ReMured/PEP/Analoger Signalgenerator.pptx

## Analoger Signalgenerator

Ein Projekt des Wahlfachs PEP von marius Heckl und Pascal palatz

## Gliederung

- Anforderungen
- Unsere Platine
- Herausforderungen und Lösungen
- Ausgangssignal Wien-Robinson-Generator
- Ausgangsignal Sinus
- Ausgangsignal Rechteck
- Ausgangsignal Dreieck
- Ausgangsignal PWM
- Ausgangsignal Sägezahn
- Weitere Videos (Amplitude und Offset)

## Anforderungen

Projekt Signalgenerator - Anforderungen -

- Entwicklung eines analogen Signalgenerators
- Folgende Signale sollen generiert werden:
  - Sinus
  - Rechteck
  - Dreieck
  - PWM
  - Sägezahn
- Frequenzen der Signale sollen zwischen 1 kHz und 1 MHz einstellbar sein
- Die Amplitude und der Offset soll bei allen Signalen einstellbar sein

## Unsere Platine

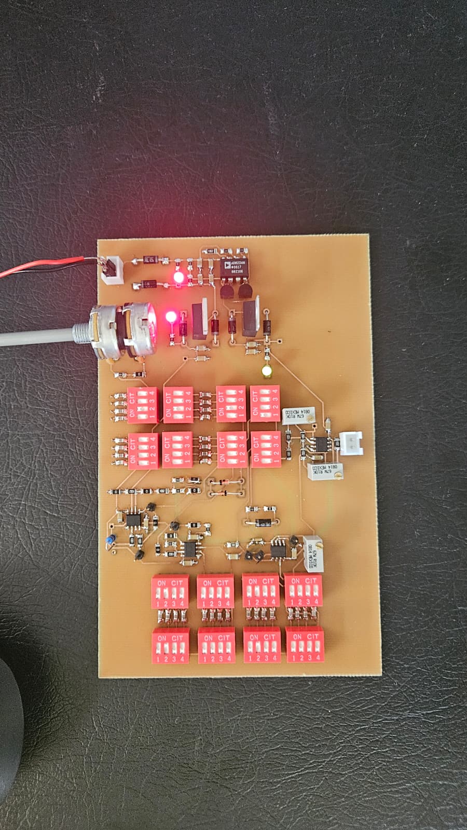
[picture p1: figure]

Projekt Signalgenerator - Unsere Platine -

- Kenndaten unserer Platine:
  - Spannungsversorgung:
    - Netzteilversorgung: ± 15 V
    - Interne Spannungsversorgung: ± 5 V
  - Signalgenerator:
    - Wien-Robinson-Generator: Erzeugt ein Sinus mit minimal 4,06 kHz und maximal 1,63 MHz
  - Signalverarbeitungen:
    - Signalerzeugung: Erzeugt aus dem Sinus des Generators :
      - Verstärkter Sinus
      - Rechteck
      - Dreieck
      - PWM
      - Sägezahn
  - Amplitude und Offset:
    - Signalmanipulation: Auswahl des Signals durch Dip-Schalter; Veränderung durch jeweiliges Potentiometer

## Schaltplan der Platine

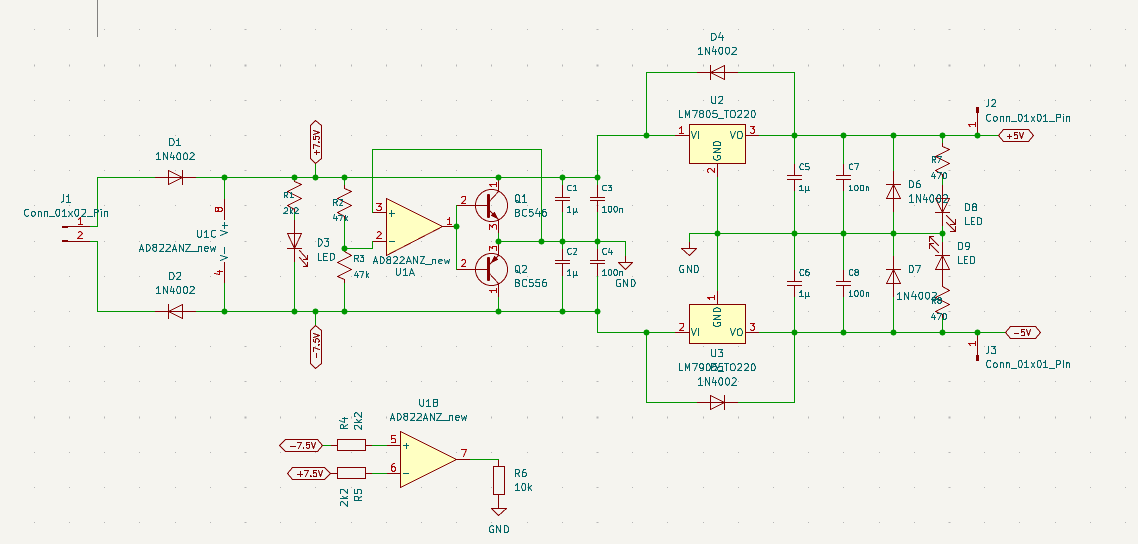
[picture p2: figure]

Der Wien-Robinson-Generator

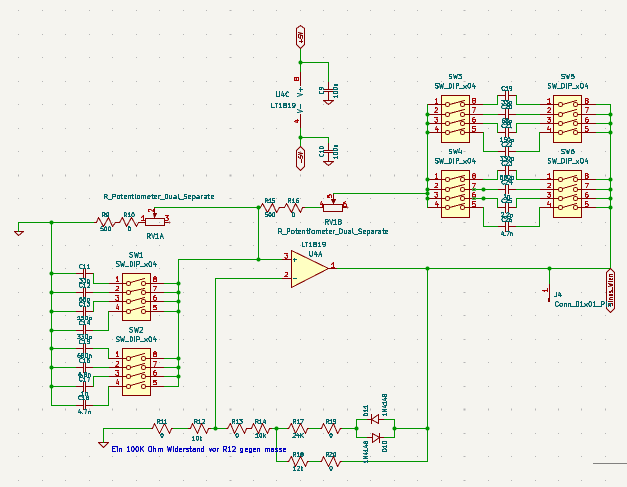
[picture p3: figure]

Die Spannungsversorgung

## Slide 6

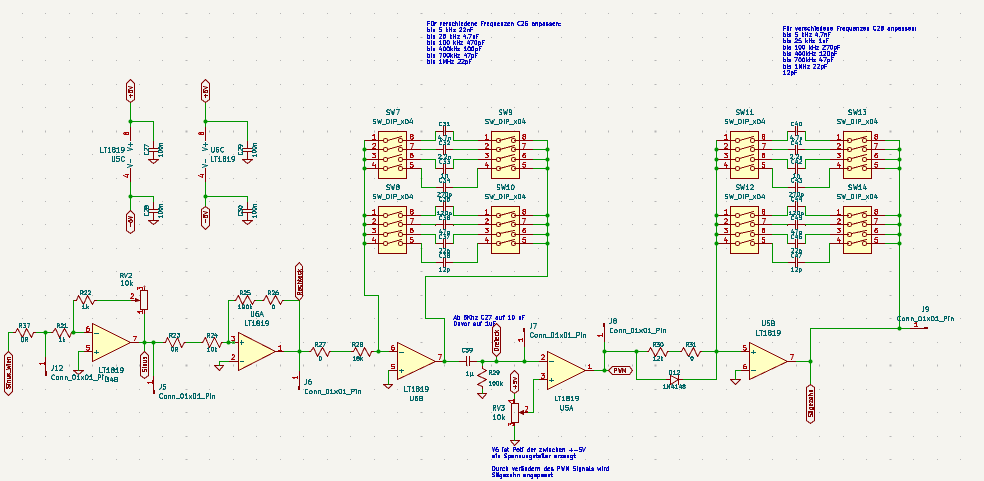
[picture p4: figure]

Die Signalverarbeitung

Amplituden und Offset Einstellung

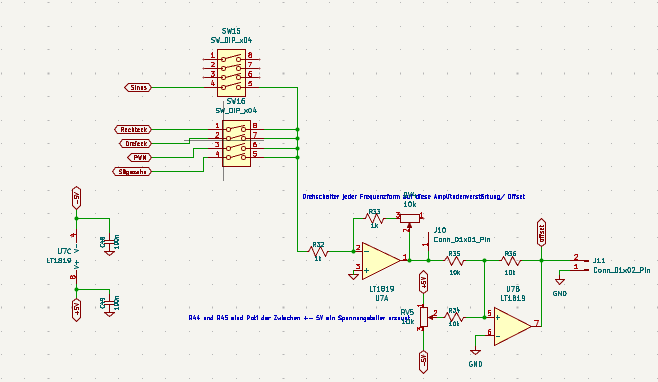
[picture p5: figure]

## Herausforderungen und Lösungen

Projekt Signalgenerator - Herausforderungen und Lösungen -

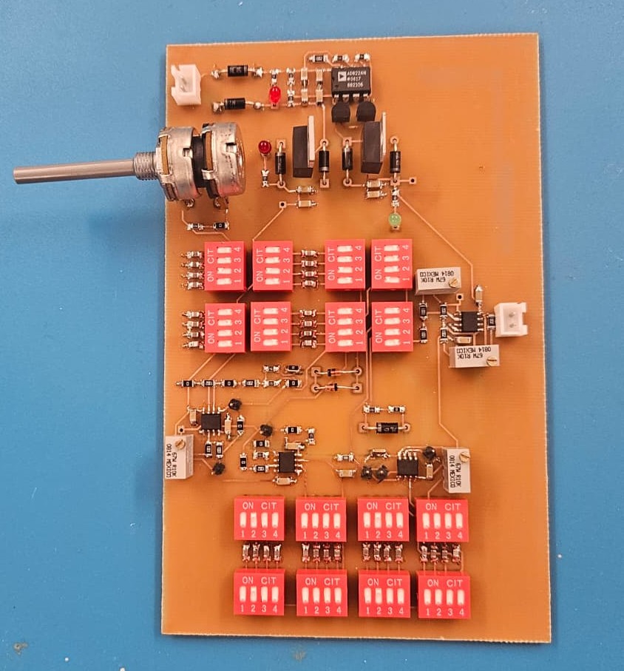
[picture p6: figure]

- Fehlerhaftes Ausgangssignal nach der Sinus-Verstärkung des Wien-Robinson-Generators
- Fehlersuche: Führt zu fehlerhaftem Potentiometer, der Verstärkungsfaktor festlegt
- Fehlerfindung: Durch Vermessen des GND, um Rauschquelle zu lokalisieren
- Fehlerbehebung: Austausch des Potentiometers durch einen weiteren 1 k Widerstand, um festen Verstärkungsfaktor von 2 einzustellen Neues Ausgangsignal dargestellt in Kapitel Ausgangsignal Sinus

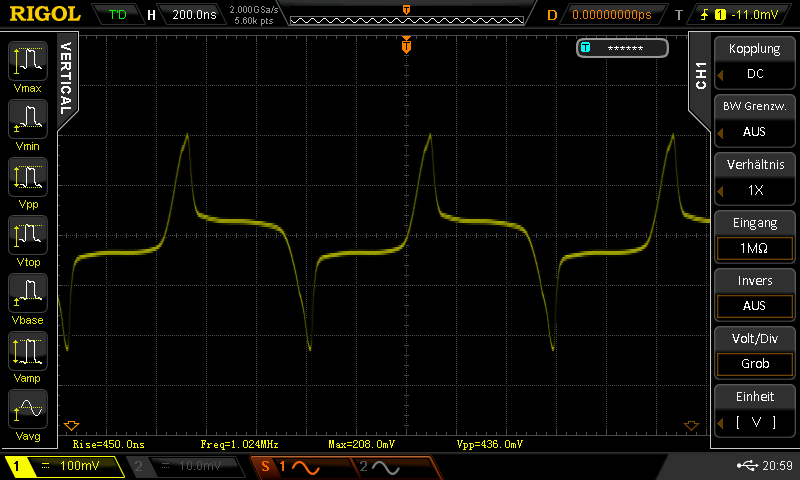
[picture p7: figure]

## Ausgangssignal Wien-Robinson-Generator

Projekt Signalgenerator - Ausgangssignal Wien-Robinson-Generator -

- Sinussignal am Ausgang des Generators

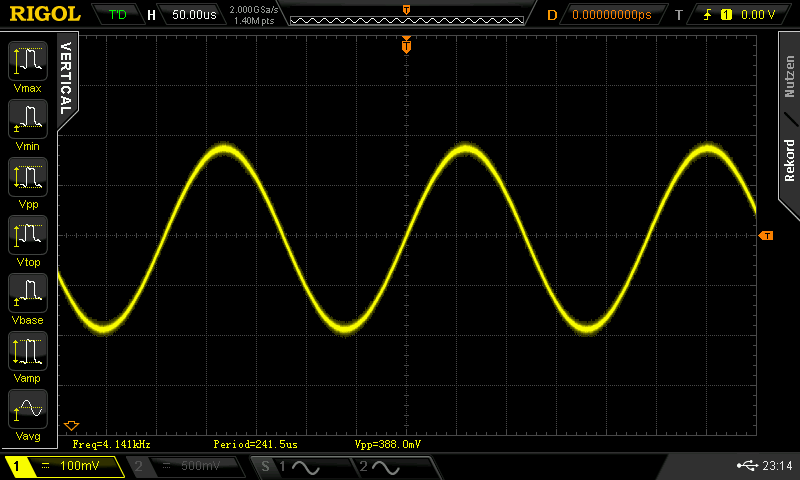
[picture p8: figure]

## Ausgangsignal Sinus

- Sinussignal nach Verstärkung des Generators durch die Frequenzen: 4,132 kHz; 10 kHz; 100 kHz; 500 kHz; 1 MHz

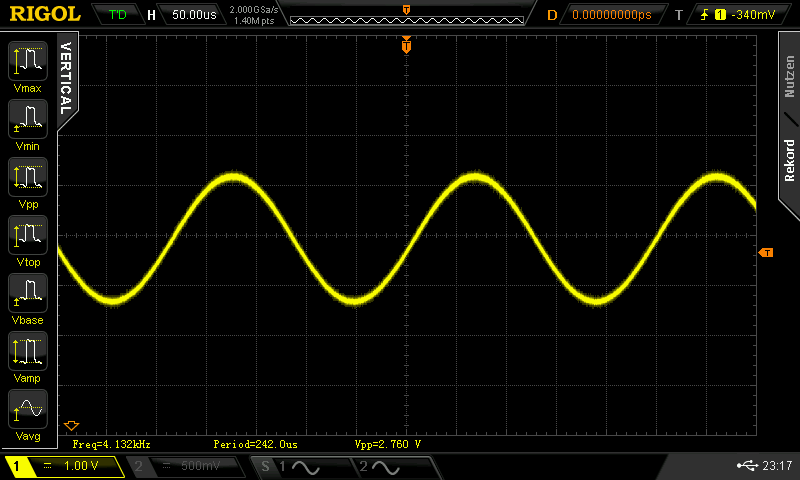
[picture p9: figure]

Projekt Signalgenerator - Ausgangssignal - Sinus -

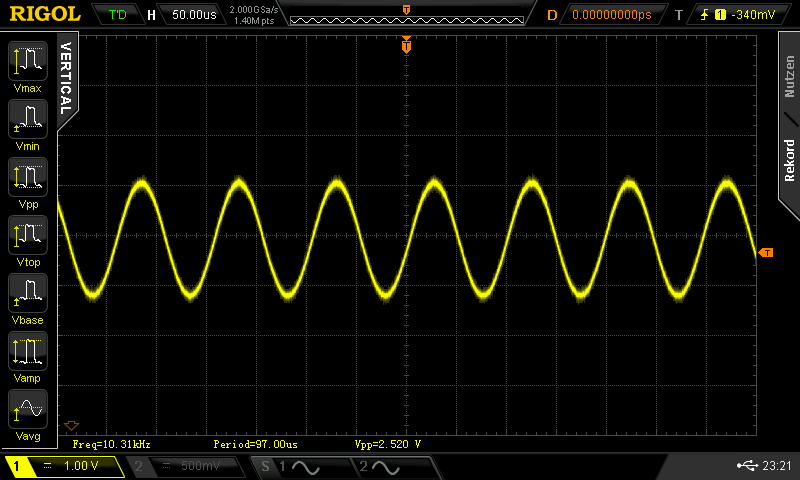
[picture p10: figure]

Sinus mit 4,132 kHz

Sinus mit 10,31 kHz

## Slide 10

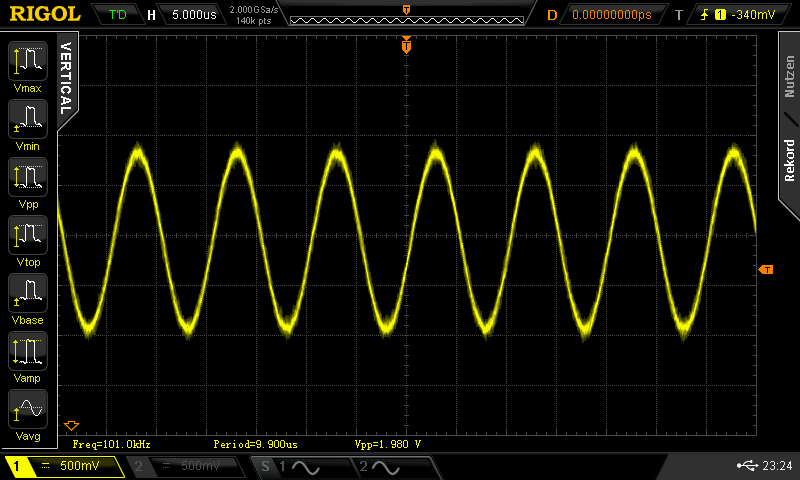
[picture p11: figure]
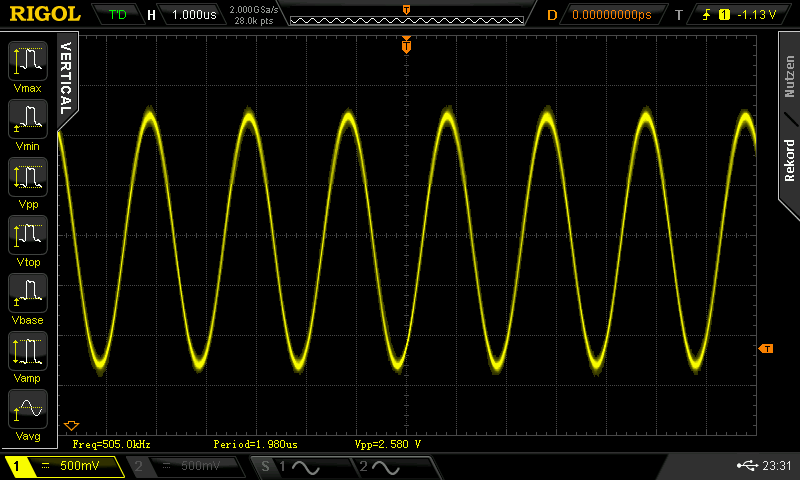
[picture p12: figure]

Sinus mit 101,0 kHz

Sinus mit 505,0 kHz

## Slide 11

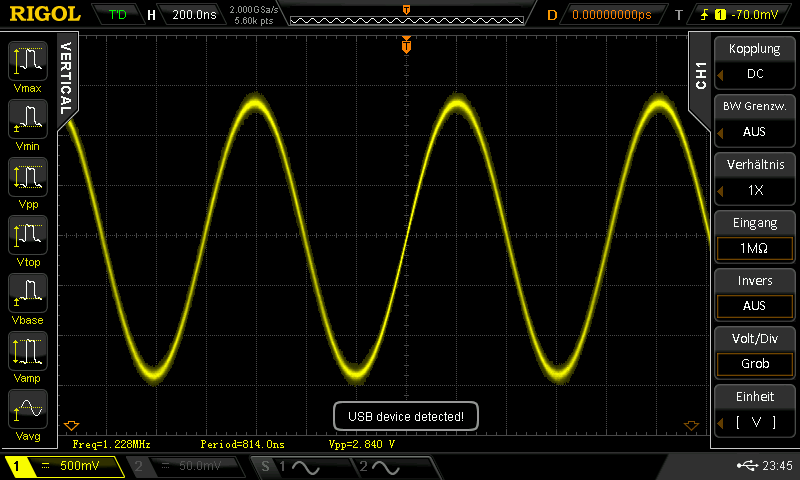
[picture p13: figure]

Sinus mit 1,228 Mhz

## Ausgangsignal Rechteck

- Rechtecksignal durch die Frequenzen: 4,132 kHz; 10 kHz; 100 kHz; 500 kHz; 1 MHz

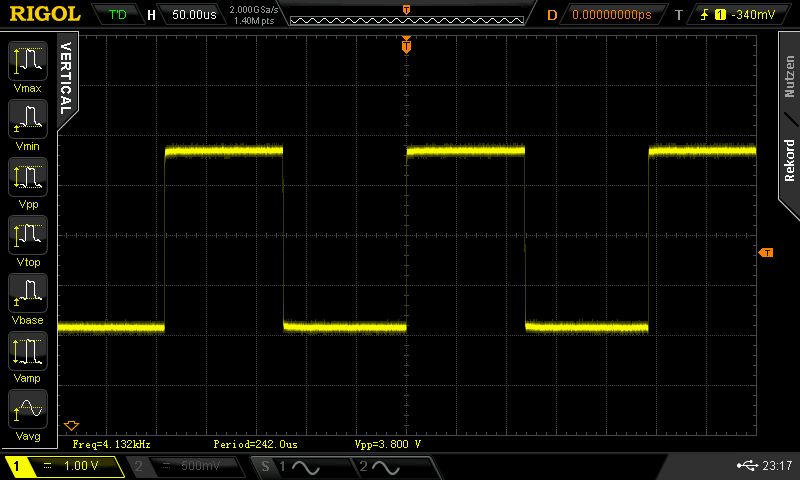
[picture p14: figure]

Rechteck mit 4,132 kHz

Projekt Signalgenerator - Ausgangssignal - Rechteck -

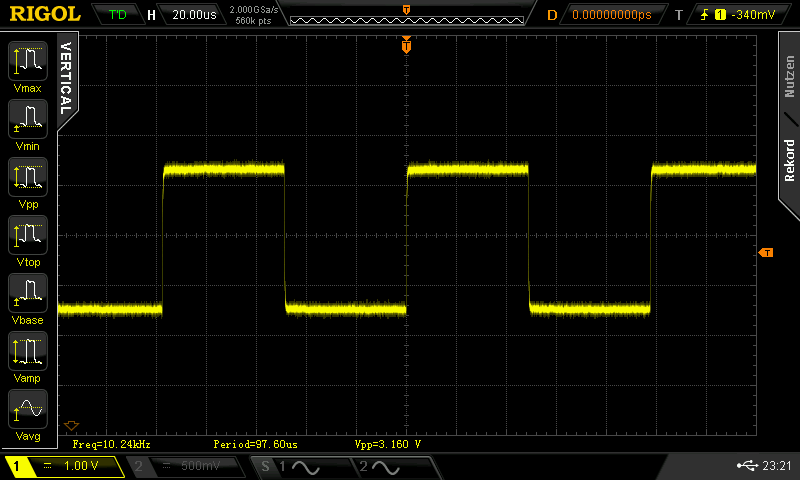
[picture p15: figure]

Rechteck mit 10,24 kHz

## Slide 13

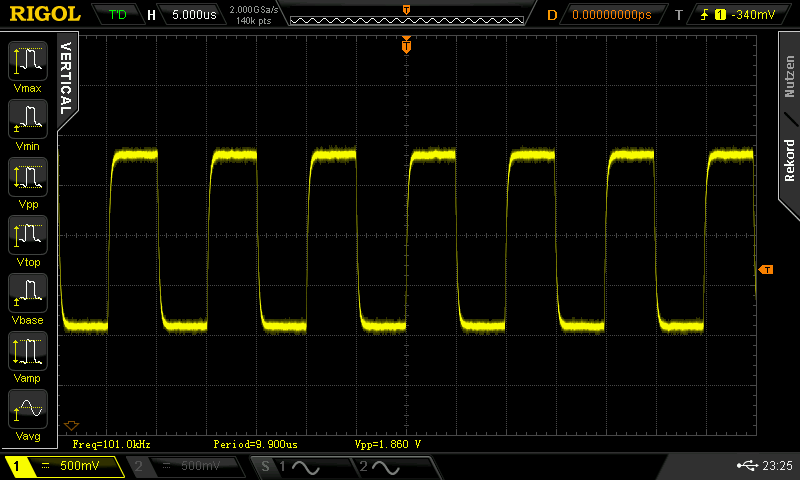
[picture p16: figure]

Rechteck mit 101,0 kHz

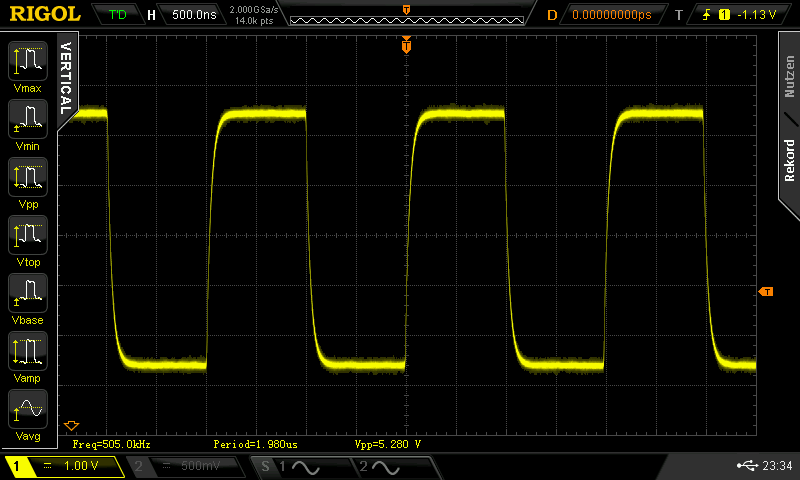
[picture p17: figure]

Rechteck mit 505,0 kHz

Projekt Signalgenerator - Ausgangssignal - Rechteck -

## Slide 14

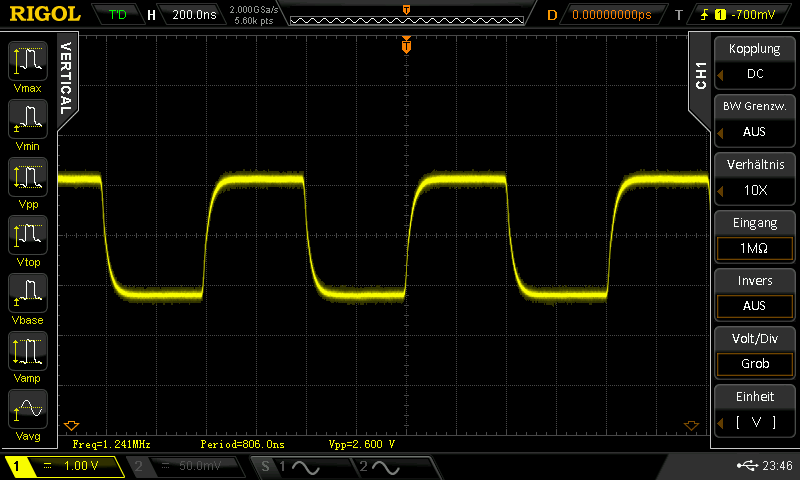
[picture p18: figure]

Rechteck mit 1,241 kHz

## Ausgangsignal Dreieck

- Dreiecksignal durch die Frequenzen: 4,132 kHz; 10 kHz; 100 kHz; 500 kHz; 1 MHz

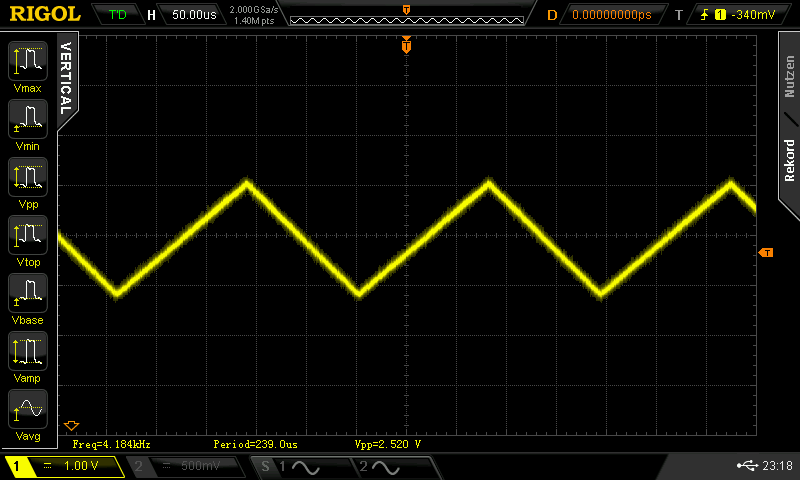
[picture p19: figure]

Dreieck mit 4,132 kHz

Projekt Signalgenerator - Ausgangssignal - Dreieck -

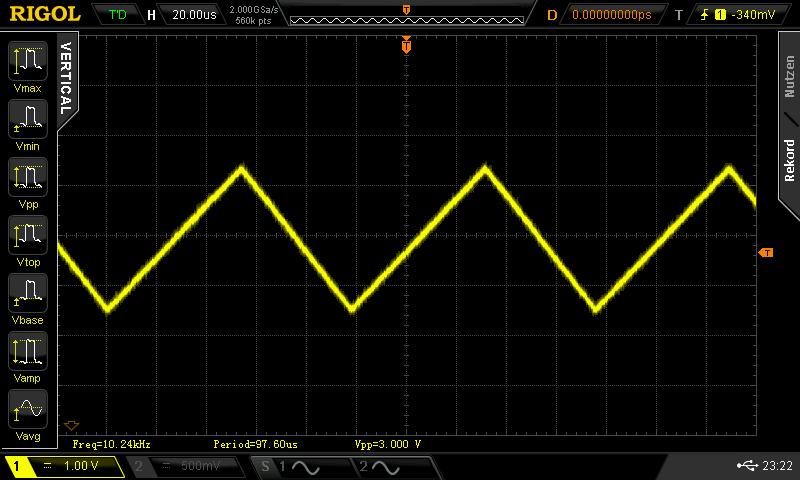
[picture p20: figure]

Dreieck mit 10,24 kHz

## Slide 16

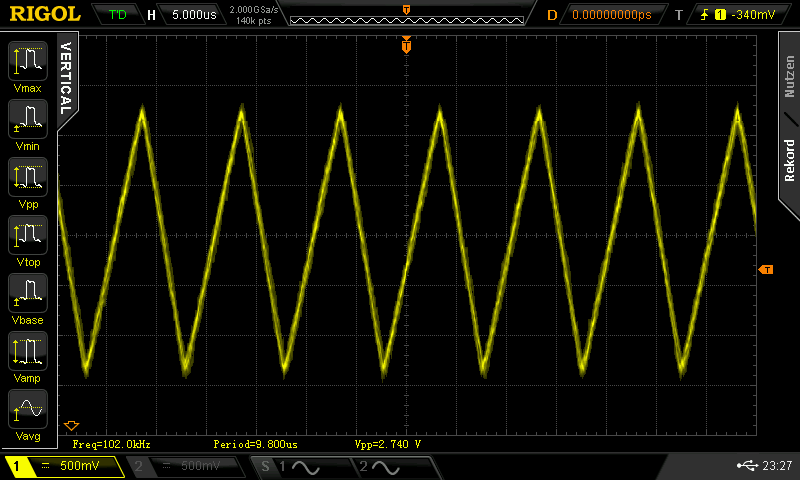
[picture p21: figure]

Dreieck mit 102,0 kHz

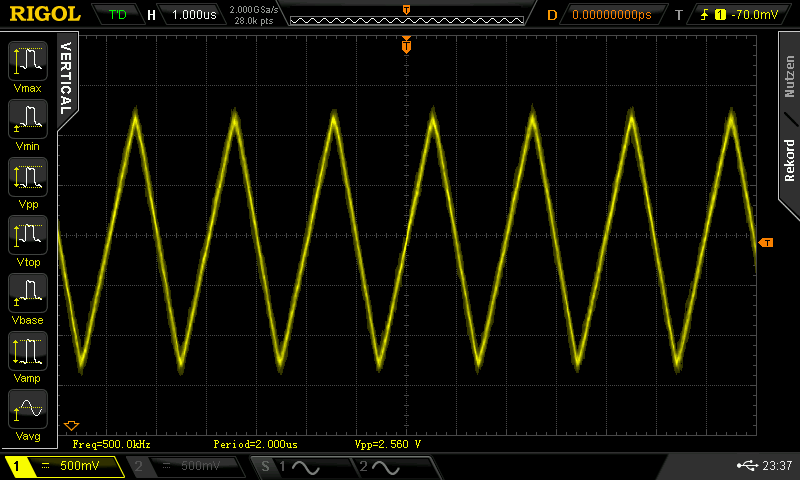
[picture p22: figure]

Dreieck mit 500 kHz

## Slide 17

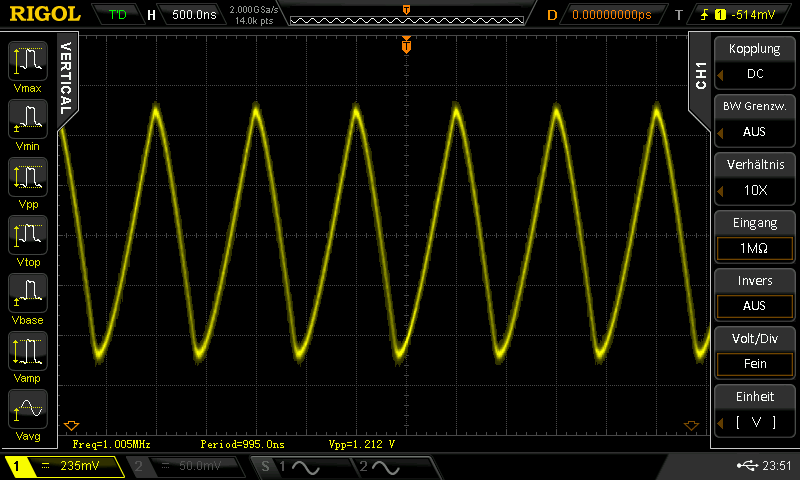
[picture p23: figure]

Dreieck mit 1,005 MHz

## Ausgangsignal PWM

- PWM-Signal durch die Frequenzen: 4,132 kHz; 10 kHz; 100 kHz; 500 kHz; 1 MHz

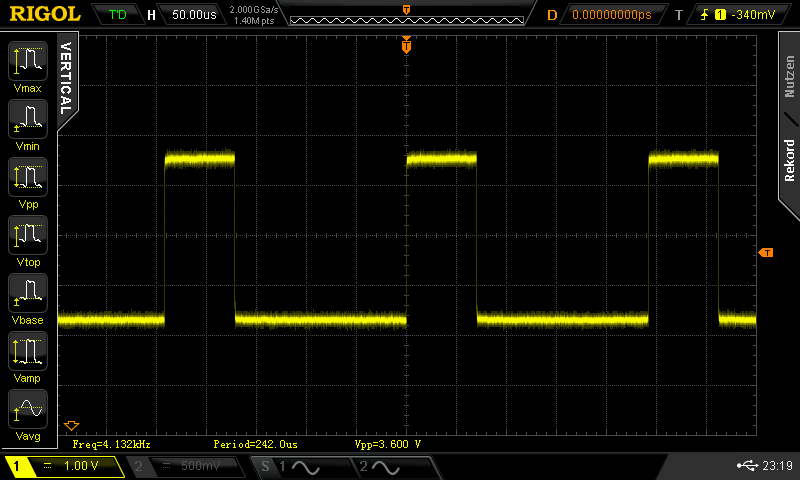
[picture p24: figure]

PWM mit 4,132 kHz und Duty Cycle von 15 %

Projekt Signalgenerator - Ausgangssignal - PWM -

PWM mit 70% Fehlt kHz

## Slide 19

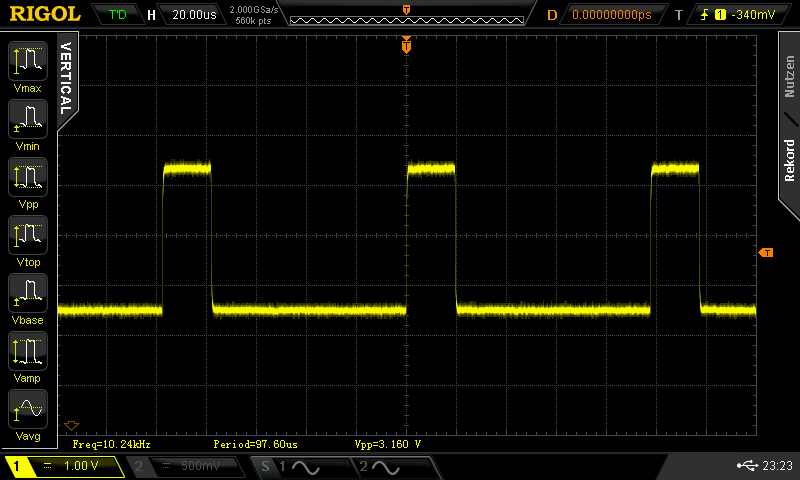
[picture p25: figure]

PWM mit 10,24 kHz und Duty Cycle von 15 %

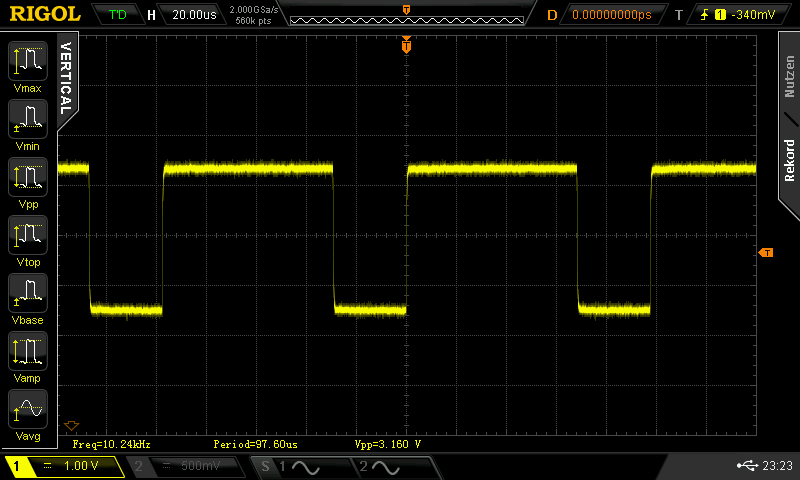
[picture p26: figure]

PWM mit 10,24 kHz und Duty Cycle von 70 %

## Slide 20

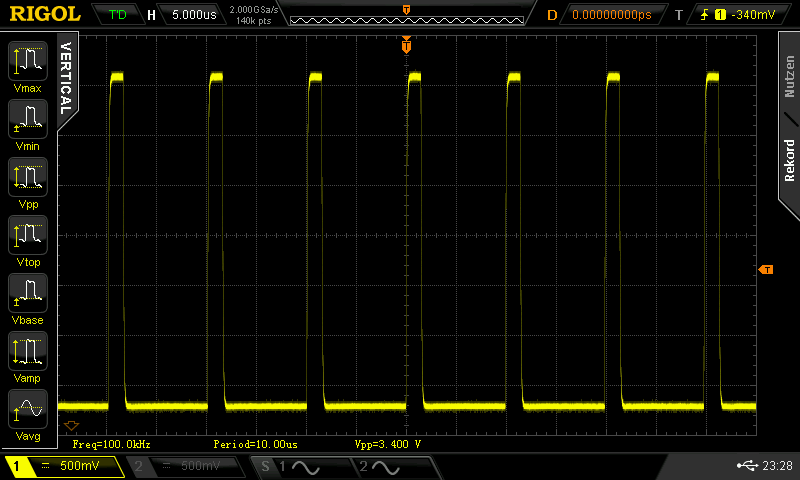
[picture p27: figure]

PWM mit 100,0 kHz und Duty Cycle von 15 %

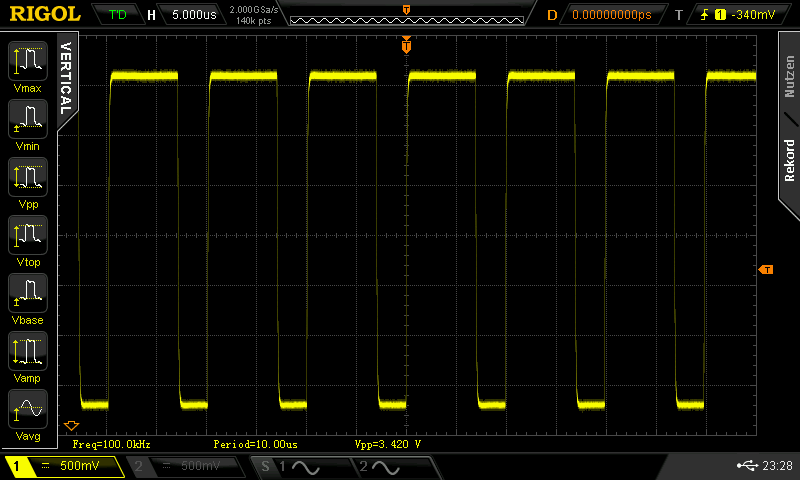
[picture p28: figure]

PWM mit 100,0 kHz und Duty Cycle von 70 %

## Slide 21

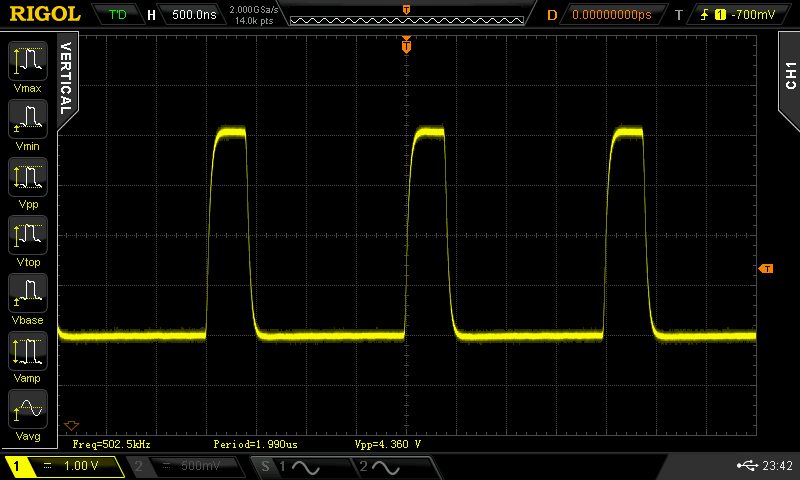
[picture p29: figure]

PWM mit 502,5 kHz und Duty Cycle von 15 %

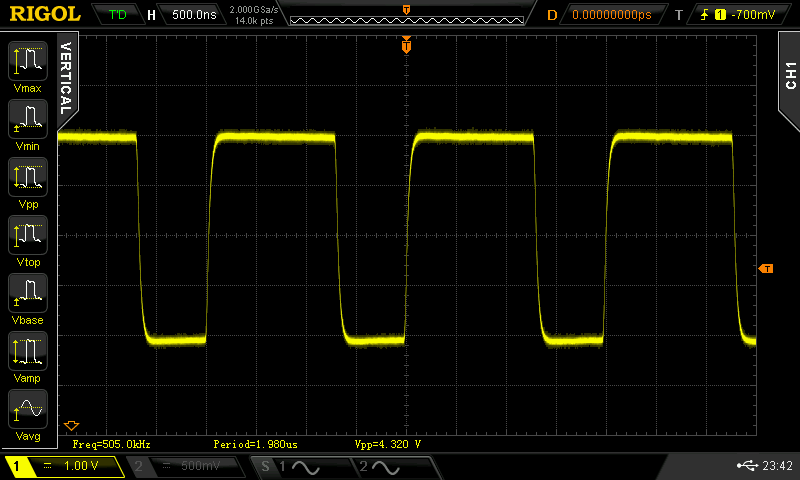
[picture p30: figure]

PWM mit 505 kHz und Duty Cycle von 70 %

## Slide 22

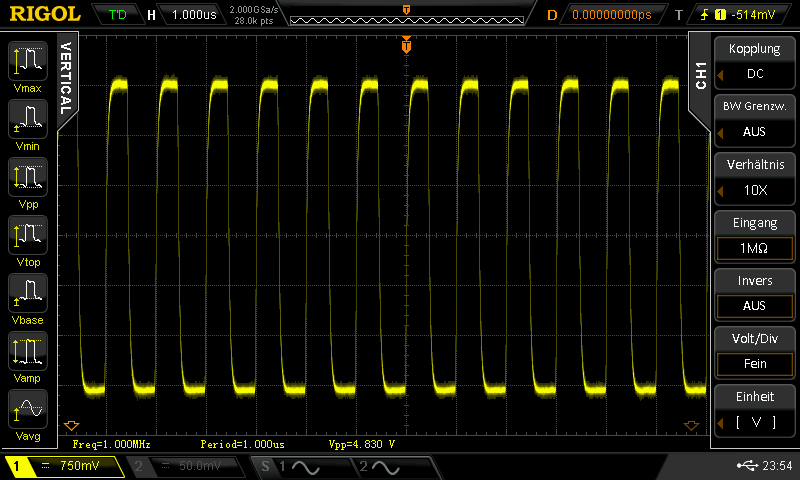
[picture p31: figure]

PWM mit 1 MHz und Duty Cycle von 45 % bei grober Betrachtung

## Slide 23

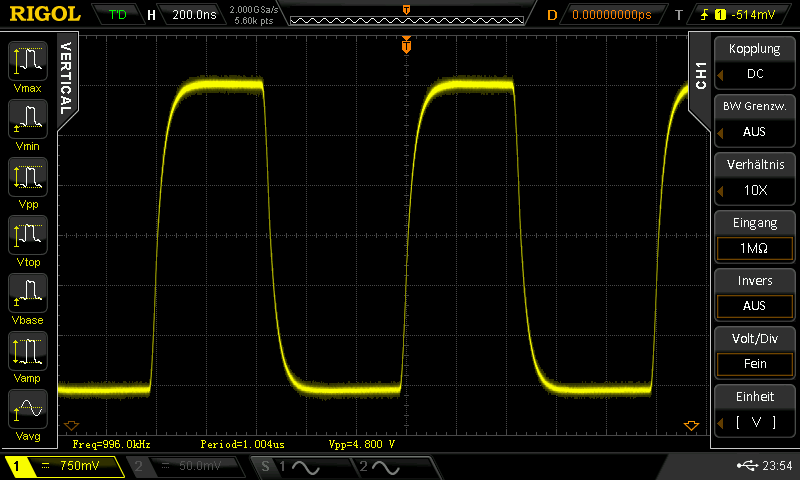
[picture p32: figure]

PWM mit 998,0 kHz und Duty Cycle von 45 % bei näherer Betrachtung

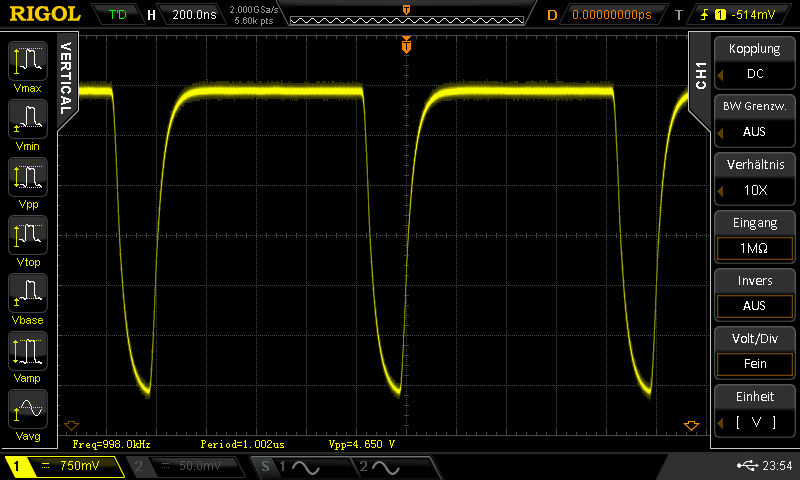
[picture p33: figure]

PWM mit 998,0 kHz und Duty Cycle von 75 %

## Ausgangsignal Sägezahn

- Sägezahn durch die Frequenzen: 4,132 kHz; 10 kHz; 100 kHz; 500 kHz; 1 MHz

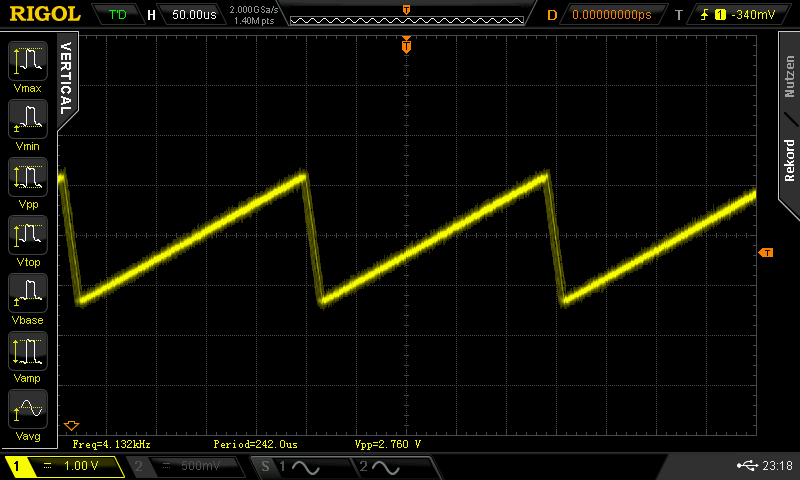
[picture p34: figure]

Sägezahn mit 4,132 kHz

Projekt Signalgenerator - Ausgangssignal - Sägezahn -

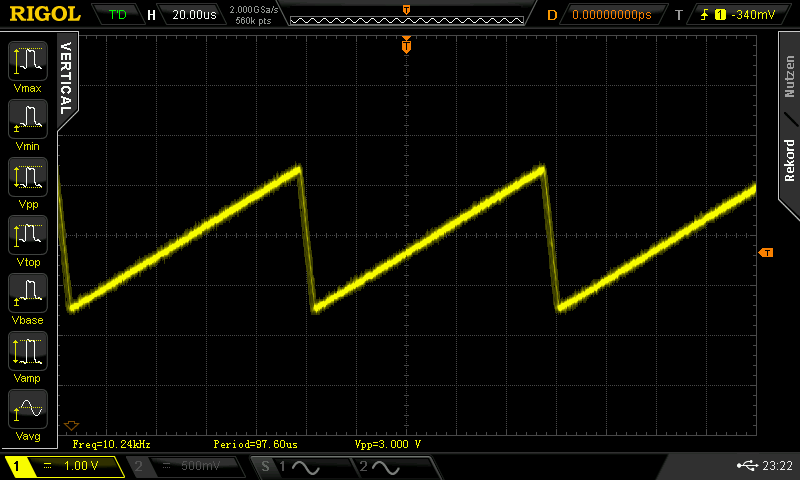
[picture p35: figure]

Sägezahn mit 10,24 kHz

## Slide 25

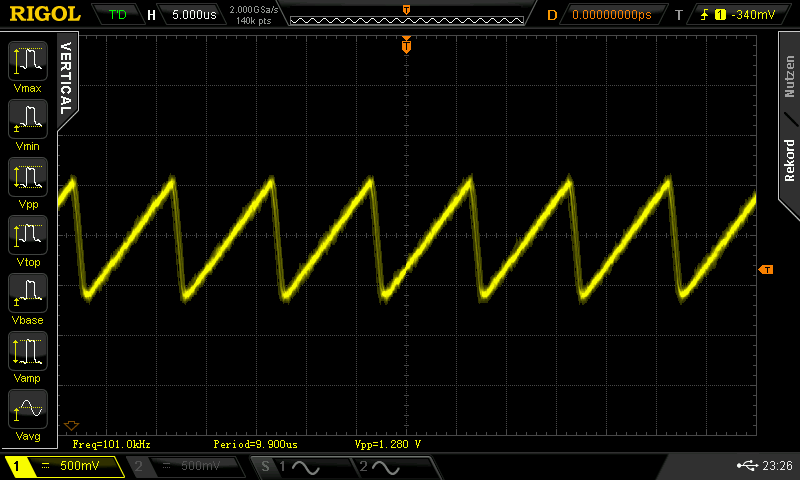
[picture p36: figure]

Sägezahn mit 101,0 kHz

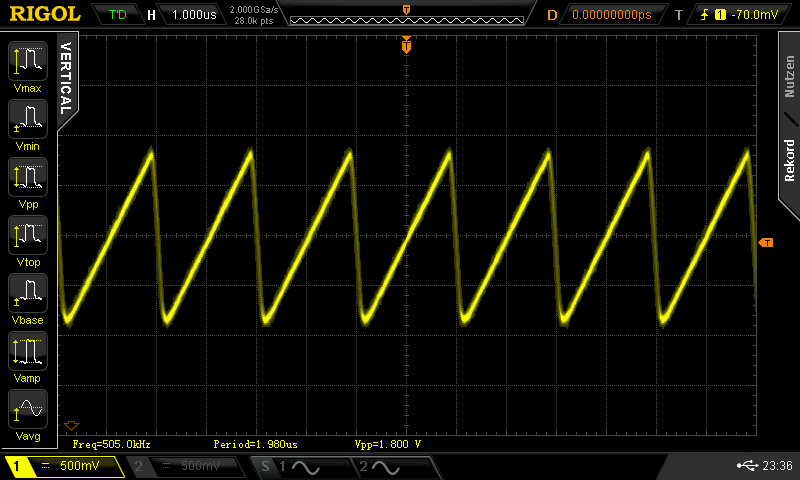
[picture p37: figure]

Sägezahn mit 505,0 kHz

## Slide 26

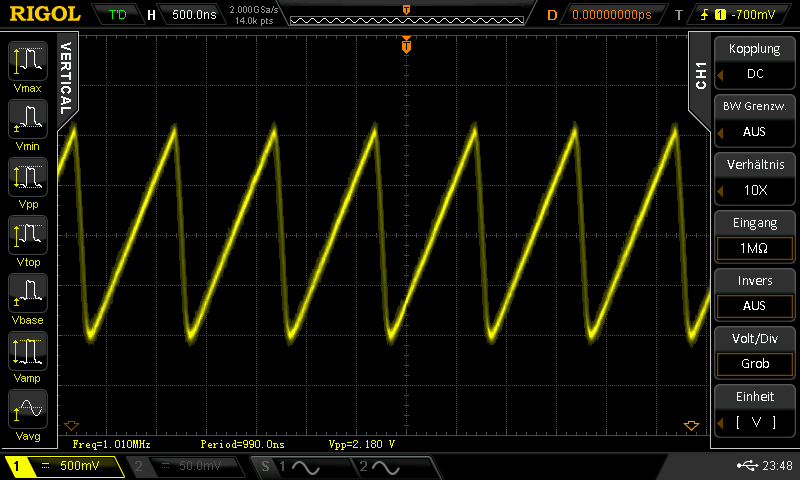
[picture p38: figure]

Sägezahn mit 1,01 MHz

## Weitere Videos (Amplitude und Offset)
