ReMured/PEP/Spannungsversorgung_5_2V.png

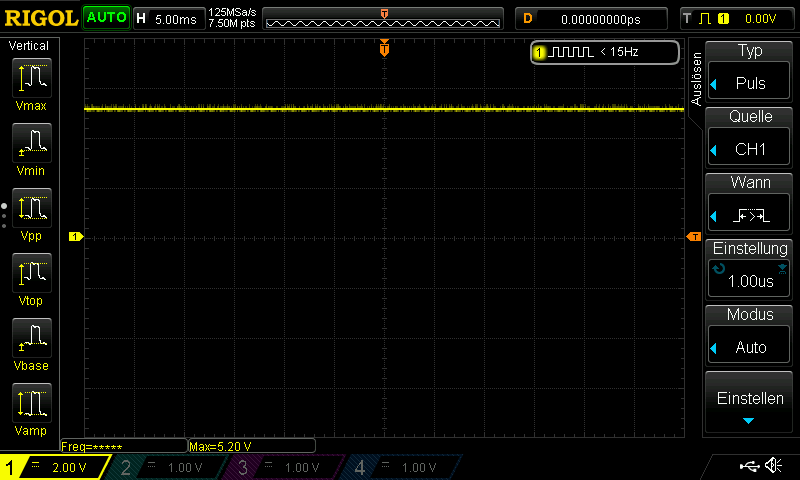
Spannungsversorgung_5_2V.png
