ReMured/PEP/Spannungsversorgung_15V.png

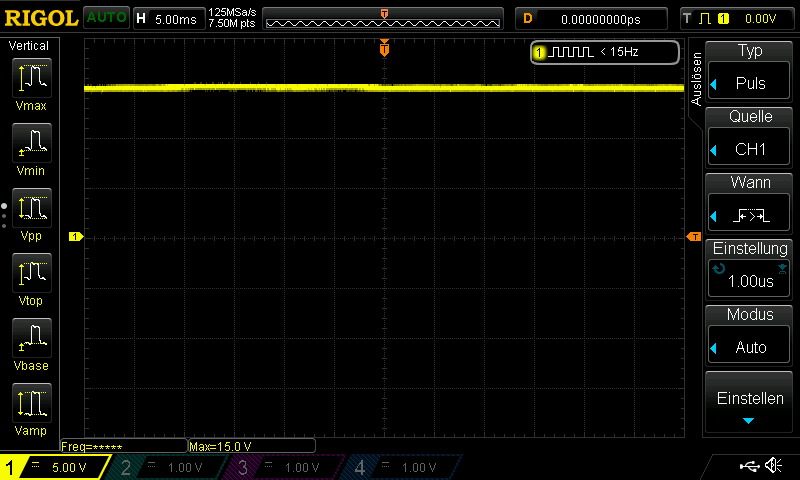
Spannungsversorgung_15V.png
