ReMured/PEP/Spannungsversorgung_-6_6V.png

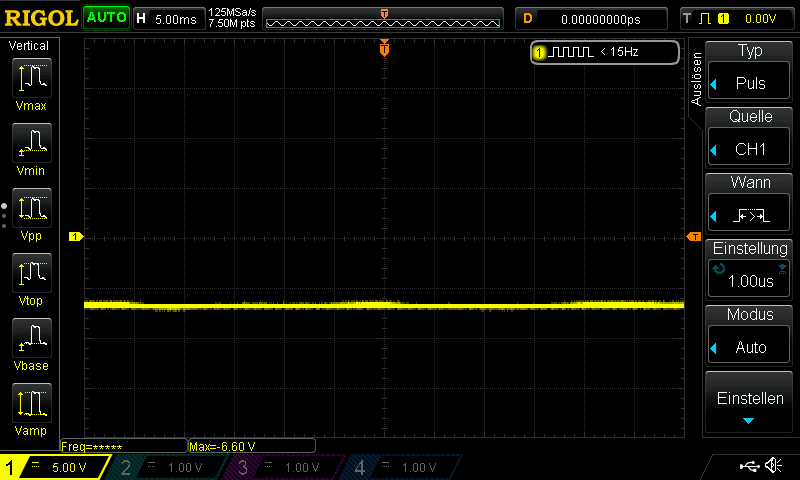
Spannungsversorgung_-6_6V.png
