ReMured/PEP/KiCad Bauteil Bib/BF256.step

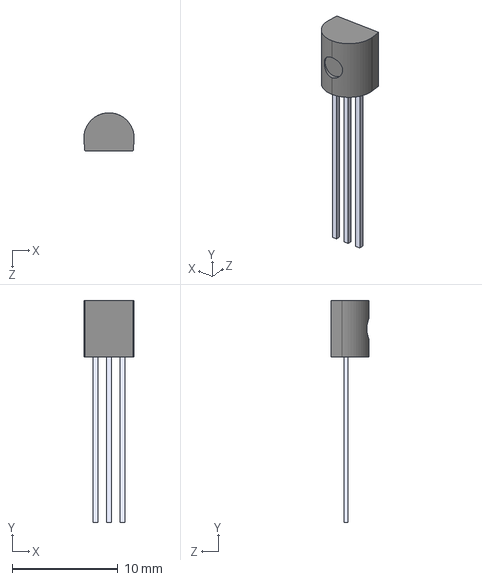
[picture p42: CAD file, 2026-05-21]
KiCad Bauteil Bib/BF256.step
4.76 x 21.0 x 3.62 mm
