ReMured/PEP/Saegezahnaufbau.asc

C1: cap; 1µ
C2: cap; 570n
C3: cap; 22p
D1: diode; 1N4148
D2: diode; 1N4148
R1: res; 2.7k
R2: res; 47k
R3: res; 47k
R4: res; 100k
R5: res; 10k
R6: res; 5k
R7: res; 100k
R8: res; 10k
U1: LT1818
V1: voltage; PULSE(0 3.3 0.5m 1n 1n 0.5m 1m 10)
V2: voltage; 5
V3: voltage; 5
Named nets: 0, +5v, -5v
.tran 0 5m 0 10u startup
