ReMured/PEP/Amplitudenverstaerkung_offset.asc

R1: res; 5k
R2: res; 1k
R3: res; 5k
R4: res; 5k
R5: res; 5k
R6: res; 5k
R7: res; 5k
R8: res; 1k
U1: LT1818
U2: LT1818
Named nets: -5v, +5v, 0, 2, offset
R6 (5K) und R7(5k) sind Poti der Zwischen +- 5V ein Spannungsteiler erzeugt
Drehschalter jeder Frequenzform auf diese Amplitudenverstärkung/ Offset
