ReMured/PEP/Wien_Robinson_Oszillator.asc

BF256B: njf
C1: cap; 150p
C2: cap; 150p
C3: cap; 22µ
D1: diode; 1N4148
R1: res; 16.5k
R2: res; 1.5k
R3: res; 0
R4: res; 10k
R5: res; 100k
R6: res; 33k
R7: res; 1.5k
R8: res; 0
U1: LT1819
V2: voltage; 5
V3: voltage; 5
Named nets: V+, V-, 0, Sinus
.tran 0 10m 0 1u startup
R2 und R3 sollen als Doppel potenziometer eingestellt werden jedoch noch mit einem festwider stand von 2k2 damit keine 0 Ohm anliegen können
.options plotwinsize=0
.model BF256B NJF(Beta=2.1m Betatce=-.5 Rd=1 Rs=1 Lambda=2m Vto=-2.5 Vtotc=-2.5m Is=114.5f Isr=1.099p N=1 Nr=2 Cgd=4p M=0.3122 Vj=0.5 Fc=0.5 Cgs=4.5p Kf=1.025E-17 Af=1)
