ReMured/PEP/Signalumwandlung.asc

10k: res; 10k
C1: cap; 22n
C2: cap; 1µ
C5: cap; 4.7n
D1: diode; 1N4148
R1: res; 20k
R2: res; 190k
R3: res; 10k
R4: res; 18k
R6: res; 100k
R17: res; 12k
U1: LT1818
U2: LT1818
U3: LT1818
U4: LT1818
U9: LT1819
V1: voltage; SINE(0 1 5k)
V2: voltage; 5
V3: voltage; 5
V4: voltage; 0.1
Named nets: 0, +5v, -5v, Dreieck, PWM, Rechteck, Sinus, Sägezahn
.tran 0 5m 0 10u startup
Für verschiedene Frequenzen C1 anpassen:
bis 5 kHz 4.7nF
bis 25 kHz 1nF
bis 100 kHz 220pF
bis 400kHz 47pF
bis 700kHz 47pF
bis 1MHz 22pF
Für verschiedene Frequenzen C1 anpassen:
bis 5 kHz 22nF
bis 25 kHz 4,7nF
bis 100 kHz 470pF
bis 400kHz 100pF
bis 700kHz 47pF
bis 1MHz 22pF
Ab 5Khz C2 auf 10 nF
Davor auf 1uF
V4 ist Poti der zwischen +-5V 
ein Spannungsteiler erzeugt
 
Durch verändern des PWM Signals wird 
Sägezahn angepasst
Sinus wird durch Wien-Rob-Generator erzeugt 
Seperate Simulation vorhanden
U1 wird benötigt, da Wien-Rob-Generator 
kleines Signal erzeugt (Verstärkung)
Spannungsversorgung wird wegen
Simulation seperat erstellt
Seperate Simulation vorhanden
Offset-Schaltung seperat vorhanden
Eine Offsetschlatung für alle Signale
wird bei Bedarf auf Signal zugeschaltet
