ReMured/PEP/Oszi.asc

C1: cap; 6.8n
C2: cap; 6.8n
C3: cap; 47µ
D1: diode; 1N4148
J2: njf; 2N3819
R1: res; 22K
R2: res; 22K
R3: res; 10k
R4: res; 20.75k
R5: res; 22k
R6: res; 10k
U1: LT1819
V1: voltage; 5
V2: voltage; 5
Named nets: 0, +5V, -5V, Sinus
.tran 0 200m 0 10u startup
