ReMured/PEP/Spannungsversorgungasc.asc

C1: cap; 100n
C2: cap; 1µ
C3: cap; 1µ
C4: cap; 100n
C5: cap; 1µ
C6: cap; 1µ
C7: cap; 100n
C8: cap; 100n
D1: diode; 1N4007
D2: diode; 1N4007
D3: diode
D4: diode
Q1: npn; 2N2222
Q2: pnp; 2N2907
R1: res; 47k
R2: res; 47k
U1: 7805
U2: LT1001
U3: 7905
V1: voltage; 15
Named nets: 0, +7.5V, -7.5V, +5V, -5V
.tran 100m
.include regulators.lib
