ReMured/PEP/PEP_Schaltplan_Layout_V1.0/PEP_Schaltplan_Layout_V1.0.kicad_pcb

## KiCad design PEP_Schaltplan_Layout_V1.0/PEP_Schaltplan_Layout_V1.0.kicad_pcb (2026-06-11)

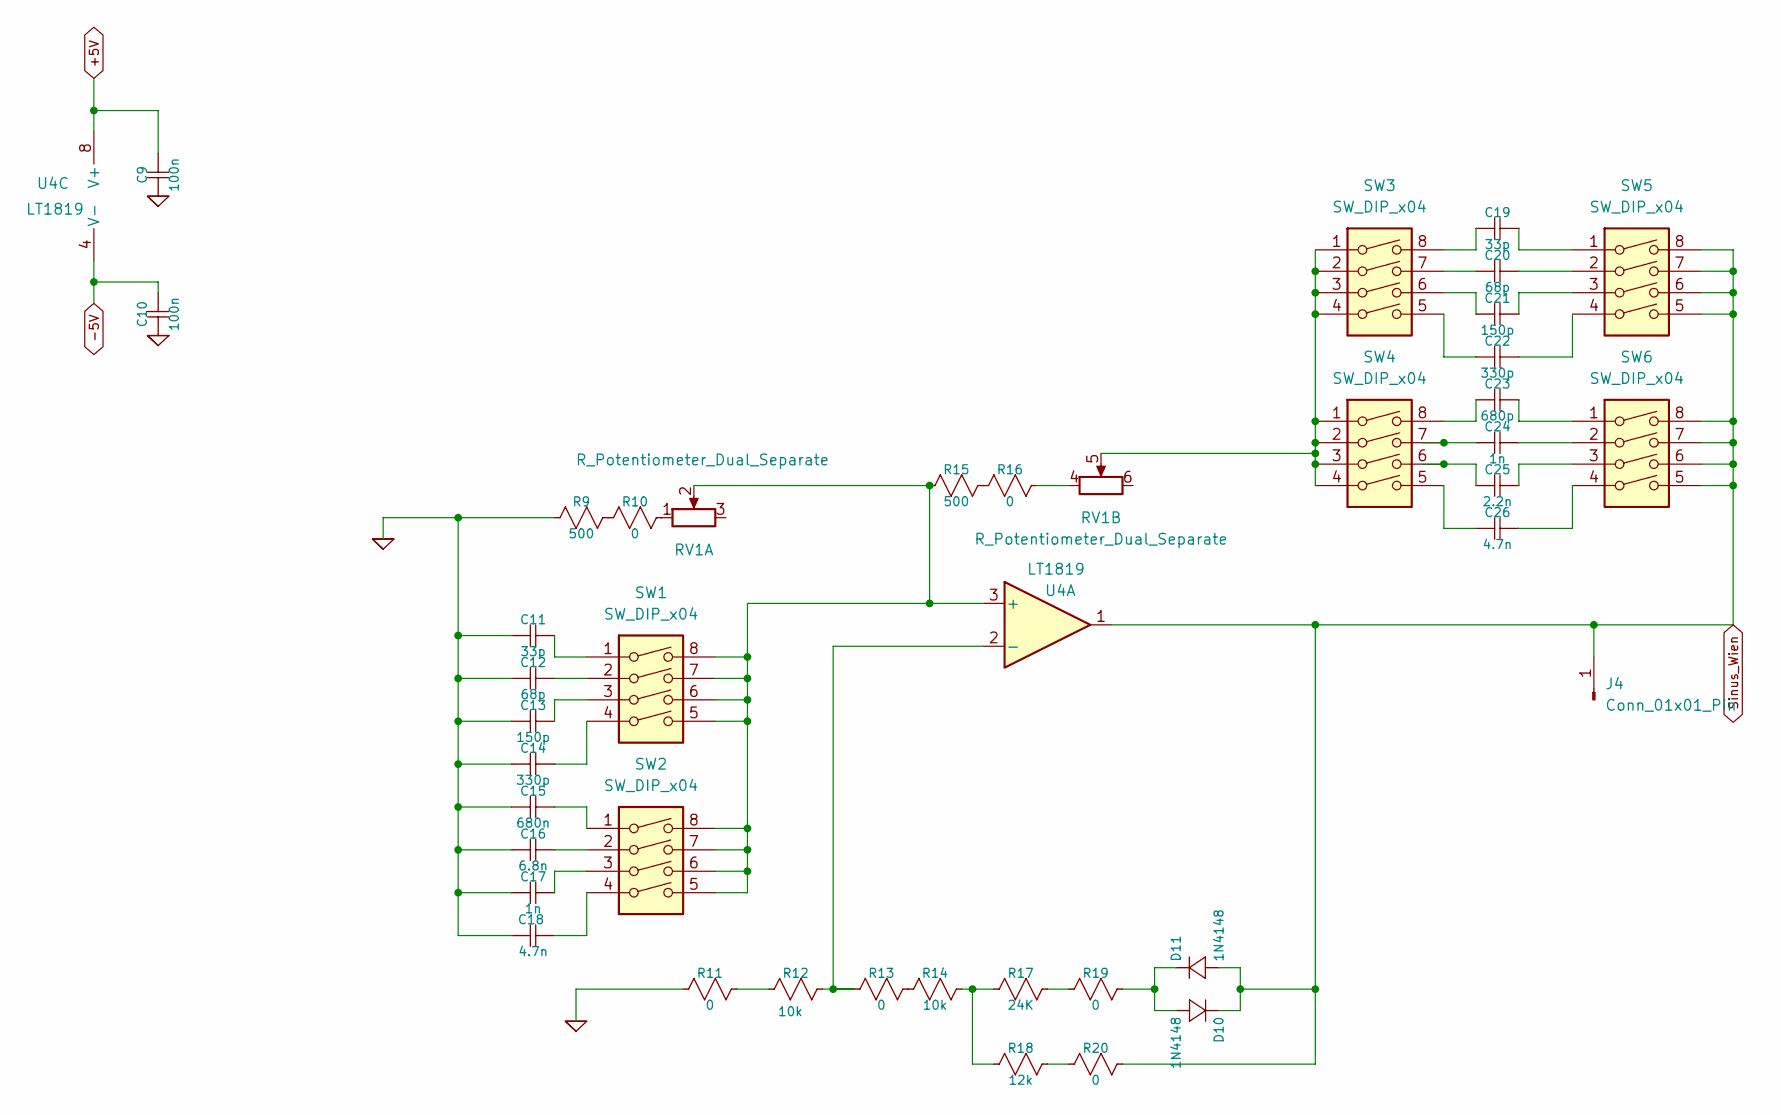
[picture p43: schematic Wien-Robinson-Generator.kicad_sch, Frequenzgenerator Heckl & Palatz]

Parts:
C9, C10: 100n; C_1206_3216Metric
C11, C19: 33p; C_1206_3216Metric
C12, C20: 68p; C_1206_3216Metric
C13, C21: 150p; C_1206_3216Metric
C14, C22: 330p; C_1206_3216Metric
C15: 680n; C_1206_3216Metric
C16: 6.8n; C_1206_3216Metric
C17, C24: 1n; C_1206_3216Metric
C18, C26: 4.7n; C_1206_3216Metric
C23: 680p; C_1206_3216Metric
C25: 2.2n; C_1206_3216Metric
D10, D11: 1N4148; D_DO-41_SOD81_P10.16mm_Horizontal
J4: Conn_01x01_Pin; PinSocket_1x01_P2.54mm_Vertical
R9, R15: 500; R_1206_3216Metric
R10, R11, R13, R16, R19, R20: 0; R_1206_3216Metric
R12, R14: 10k; R_1206_3216Metric
R17: 24K; R_1206_3216Metric
R18: 12k; R_1206_3216Metric
RV1: R_Potentiometer_Dual_Separate; Potentiometer_Piher_T-16H_Double_Horizontal
SW1, SW2, SW3, SW4, SW5, SW6: SW_DIP_x04; SW_DIP_SPSTx04_Slide_6.7x11.72mm_W7.62mm_P2.54mm_LowProfile
U4: LT1819; SO-8_3.9x4.9mm_P1.27mm

Connections:
+5V: C9.1, U4.8 (V+); also elsewhere on the board
-5V: C10.1, U4.4 (V-); also elsewhere on the board
GND: C9.2, C10.2, C11.2, C12.2, C13.2, C14.2, C15.2, C16.2, C17.2, C18.2, R9.2, R11.2; also elsewhere on the board
unnamed: C11.1, SW1.1
unnamed: C12.1, SW1.2
unnamed: C13.1, SW1.3
unnamed: C14.1, SW1.4
unnamed: C15.1, SW2.1
unnamed: C16.1, SW2.2
unnamed: C17.1, SW2.3
unnamed: C18.1, SW2.4
unnamed: C19.1, SW5.1
unnamed: C19.2, SW3.8
unnamed: C20.1, SW5.2
unnamed: C20.2, SW3.7
unnamed: C21.1, SW5.3
unnamed: C21.2, SW3.6
unnamed: C22.1, SW5.4
unnamed: C22.2, SW3.5
unnamed: C23.1, SW6.1
unnamed: C23.2, SW4.8
unnamed: C24.1, SW6.2
unnamed: C24.2, SW4.7
unnamed: C25.1, SW6.3
unnamed: C25.2, SW4.6
unnamed: C26.1, SW6.4
unnamed: C26.2, SW4.5
unnamed: D10.1 (+), D11.2 (-), R19.1
unnamed: R10.1, RV1.1
unnamed: R9.1, R10.2
unnamed: R11.1, R12.2
unnamed: R13.1, R14.2
unnamed: R14.1, R17.2, R18.2
unnamed: R15.1, R16.2
unnamed: R16.1, RV1.4
unnamed: R17.1, R19.2
unnamed: R18.1, R20.2
unnamed: RV1.5, SW3.1, SW3.2, SW3.3, SW3.4, SW4.1, SW4.2, SW4.3, SW4.4
unnamed: R15.2, RV1.2, SW1.5, SW1.6, SW1.7, SW1.8, SW2.5, SW2.6, SW2.7, SW2.8, U4.3 (+)
unnamed: R12.1, R13.2, U4.2 (-)
Sinus_Wien: D10.2 (-), D11.1 (+), J4.1 (Pin_1_1), R20.1, SW5.5, SW5.6, SW5.7, SW5.8, SW6.5, SW6.6, SW6.7, SW6.8, U4.1; also elsewhere on the board

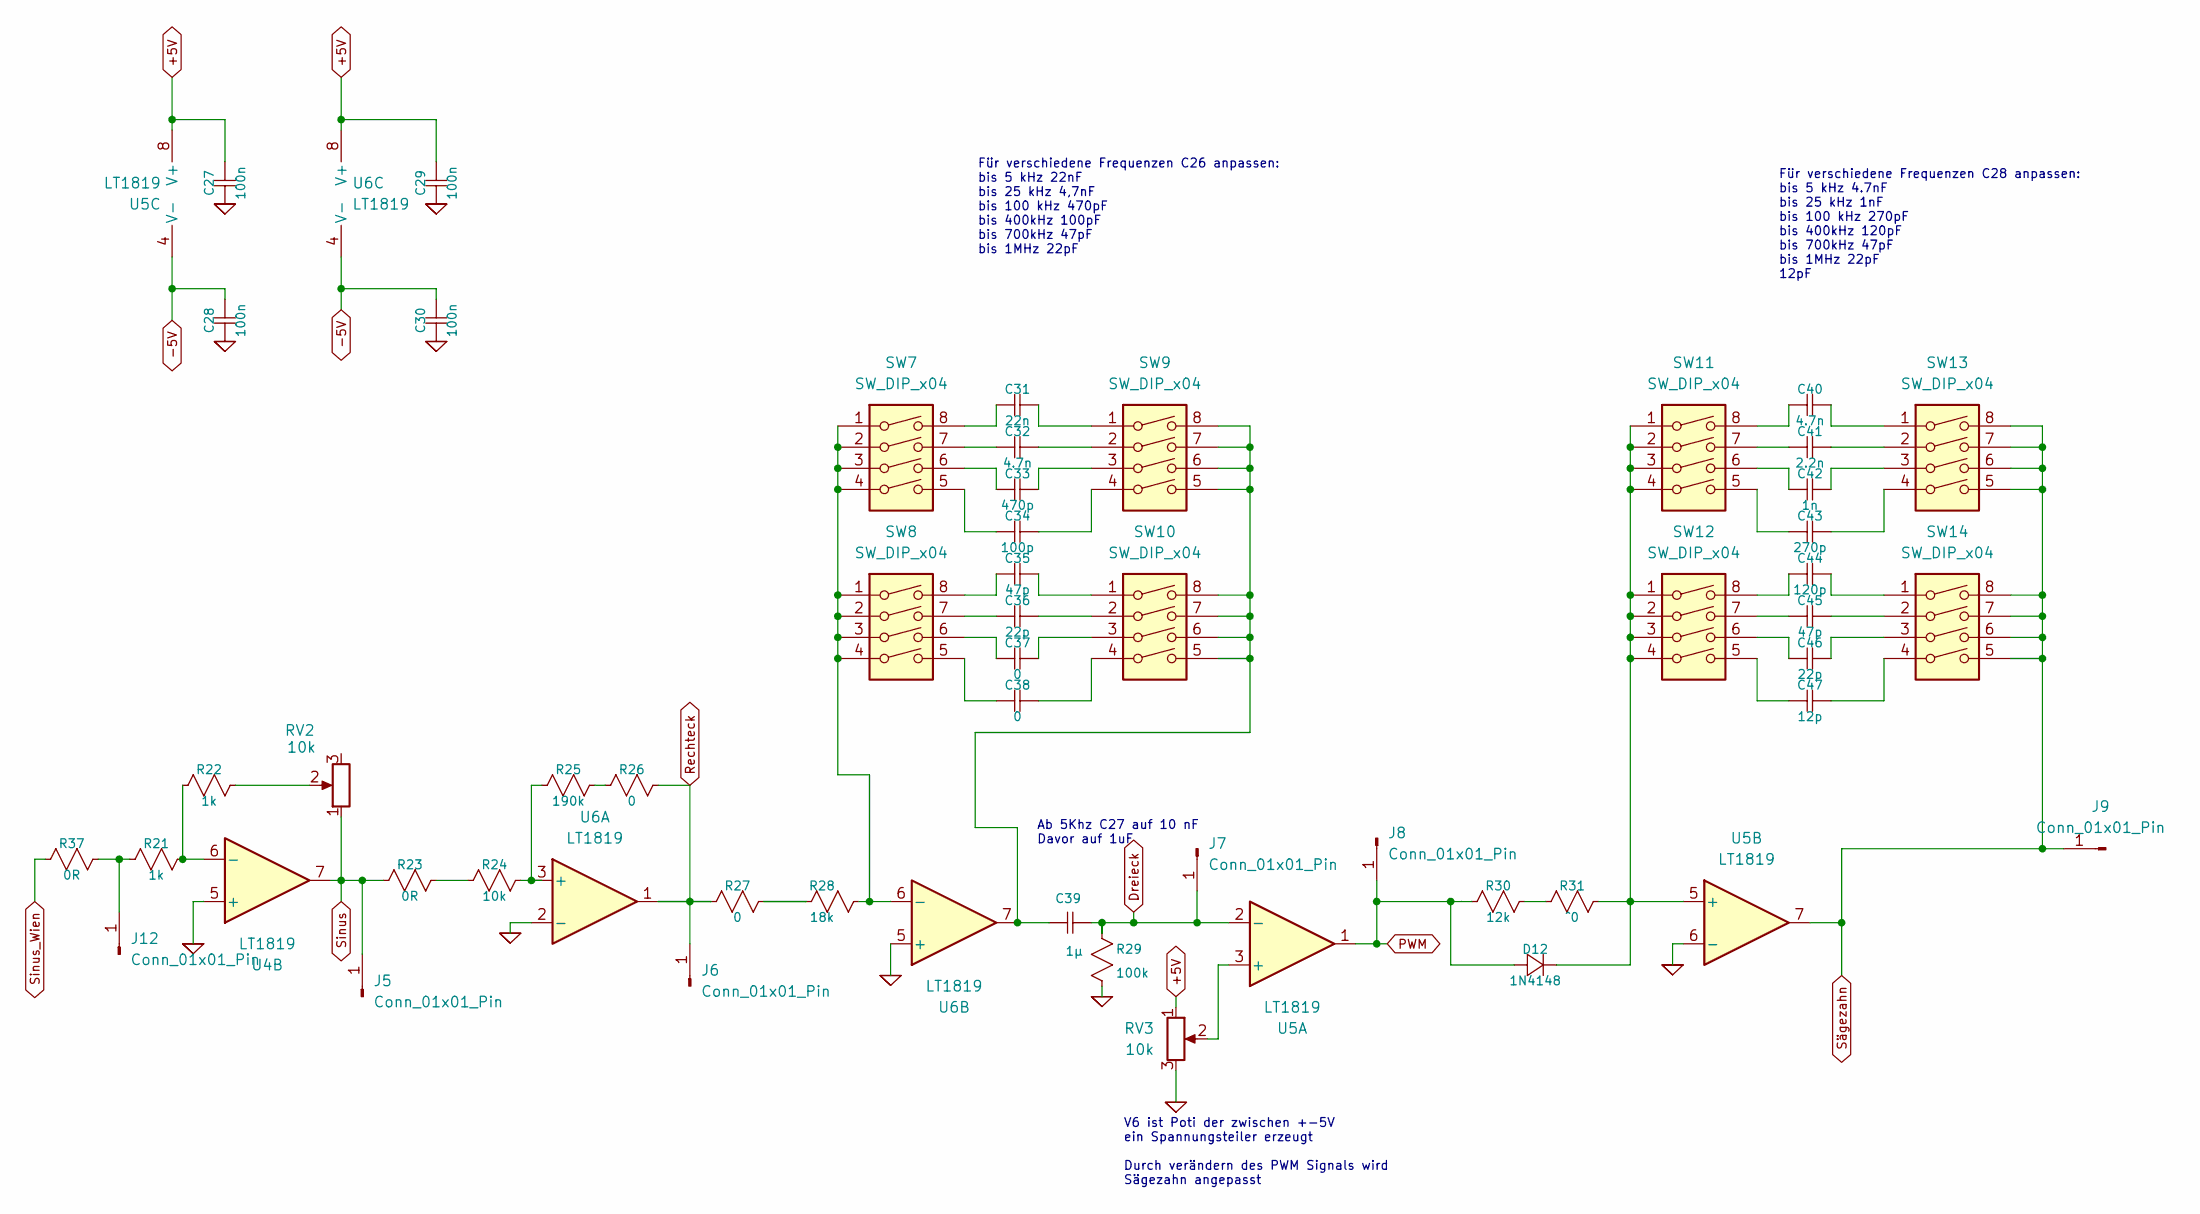
[picture p44: schematic Signalverarebeitung.kicad_sch, Frequenzgenerator Heckl & Palatz]

Parts:
C27, C28, C29, C30: 100n; C_1206_3216Metric
C31: 22n; C_1206_3216Metric
C32, C40: 4.7n; C_1206_3216Metric
C33: 470p; C_1206_3216Metric
C34: 100p; C_1206_3216Metric
C35, C45: 47p; C_1206_3216Metric
C36, C46: 22p; C_1206_3216Metric
C37, C38: 0; C_1206_3216Metric
C39: 1µ; C_1206_3216Metric
C41: 2.2n; C_1206_3216Metric
C42: 1n; C_1206_3216Metric
C43: 270p; C_1206_3216Metric
C44: 120p; C_1206_3216Metric
C47: 12p; C_1206_3216Metric
D12: 1N4148; D_DO-41_SOD81_P10.16mm_Horizontal
J5, J6, J7, J8, J9, J12: Conn_01x01_Pin; PinSocket_1x01_P2.54mm_Vertical
R21, R22: 1k; R_1206_3216Metric
R23, R37: 0R; R_1206_3216Metric
R24: 10k; R_1206_3216Metric
R25: 190k; R_1206_3216Metric
R26, R27: 0; R_1206_3216Metric
R28: 18k; R_1206_3216Metric
R29: 100k; R_1206_3216Metric
R30: 12k; R_1206_3216Metric
R31: ^0; R_1206_3216Metric
RV2, RV3: 10k; Potentiometer_Bourns_3266Y_Vertical
SW7, SW8, SW9, SW10, SW11, SW12, SW13, SW14: SW_DIP_x04; SW_DIP_SPSTx04_Slide_6.7x11.72mm_W7.62mm_P2.54mm_LowProfile
U4, U5, U6: LT1819; SO-8_3.9x4.9mm_P1.27mm

Connections:
+5V: C27.1, C29.1, RV3.1, U5.8 (V+), U6.8 (V+); also elsewhere on the board
-5V: C28.1, C30.1, U5.4 (V-), U6.4 (V-); also elsewhere on the board
Dreieck: C39.1, J7.1 (Pin_1_1), R29.1, U5.2 (-); also elsewhere on the board
GND: C27.2, C28.2, C29.2, C30.2, R29.2, RV3.3, U4.5 (+), U5.6 (-), U6.2 (-), U6.5 (+); also elsewhere on the board
unnamed: C31.1, SW9.1
unnamed: C31.2, SW7.8
unnamed: C32.1, SW9.2
unnamed: C32.2, SW7.7
unnamed: C33.1, SW9.3
unnamed: C33.2, SW7.6
unnamed: C34.1, SW9.4
unnamed: C34.2, SW7.5
unnamed: C35.1, SW10.1
unnamed: C35.2, SW8.8
unnamed: C36.1, SW10.2
unnamed: C36.2, SW8.7
unnamed: C37.1, SW10.3
unnamed: C37.2, SW8.6
unnamed: C38.1, SW10.4
unnamed: C38.2, SW8.5
unnamed: C39.2, SW9.5, SW9.6, SW9.7, SW9.8, SW10.5, SW10.6, SW10.7, SW10.8, U6.7
unnamed: C40.1, SW13.1
unnamed: C40.2, SW11.8
unnamed: C41.1, SW13.2
unnamed: C41.2, SW11.7
unnamed: C42.1, SW13.3
unnamed: C42.2, SW11.6
unnamed: C43.1, SW13.4
unnamed: C43.2, SW11.5
unnamed: C44.1, SW14.1
unnamed: C44.2, SW12.8
unnamed: C45.1, SW14.2
unnamed: C45.2, SW12.7
unnamed: C46.1, SW14.3
unnamed: C46.2, SW12.6
unnamed: C47.1, SW14.4
unnamed: C47.2, SW12.5
unnamed: D12.2 (-), R31.1, SW11.1, SW11.2, SW11.3, SW11.4, SW12.1, SW12.2, SW12.3, SW12.4, U5.5 (+)
unnamed: J12.1 (Pin_1_1), R21.2, R37.1
unnamed: R22.1, RV2.2
unnamed: R23.1, R24.2
unnamed: R25.1, R26.2
unnamed: R27.1, R28.2
unnamed: R30.1, R31.2
unnamed: R21.1, R22.2, U4.6 (-)
unnamed: RV3.2, U5.3 (+)
unnamed: R24.1, R25.2, U6.3 (+)
unnamed: R28.1, SW7.1, SW7.2, SW7.3, SW7.4, SW8.1, SW8.2, SW8.3, SW8.4, U6.6 (-)
PWM: D12.1 (+), J8.1 (Pin_1_1), R30.2, U5.1; also elsewhere on the board
Rechteck: J6.1 (Pin_1_1), R26.1, R27.2, U6.1; also elsewhere on the board
Sinus: J5.1 (Pin_1_1), R23.2, RV2.1, U4.7; also elsewhere on the board
Sinus_Wien: R37.2; also elsewhere on the board
Sägezahn: J9.1 (Pin_1_1), SW13.5, SW13.6, SW13.7, SW13.8, SW14.5, SW14.6, SW14.7, SW14.8, U5.7; also elsewhere on the board

Notes on the sheet:
V6 ist Poti der zwischen +-5V ein Spannungsteiler erzeugt Durch verändern des PWM Signals wird Sägezahn angepasst
Für verschiedene Frequenzen C28 anpassen: bis 5 kHz 4.7nF bis 25 kHz 1nF bis 100 kHz 270pF bis 400kHz 120pF bis 700kHz 47pF bis 1MHz 22pF 12pF
Für verschiedene Frequenzen C26 anpassen: bis 5 kHz 22nF bis 25 kHz 4,7nF bis 100 kHz 470pF bis 400kHz 100pF bis 700kHz 47pF bis 1MHz 22pF
Ab 5Khz C27 auf 10 nF Davor auf 1uF

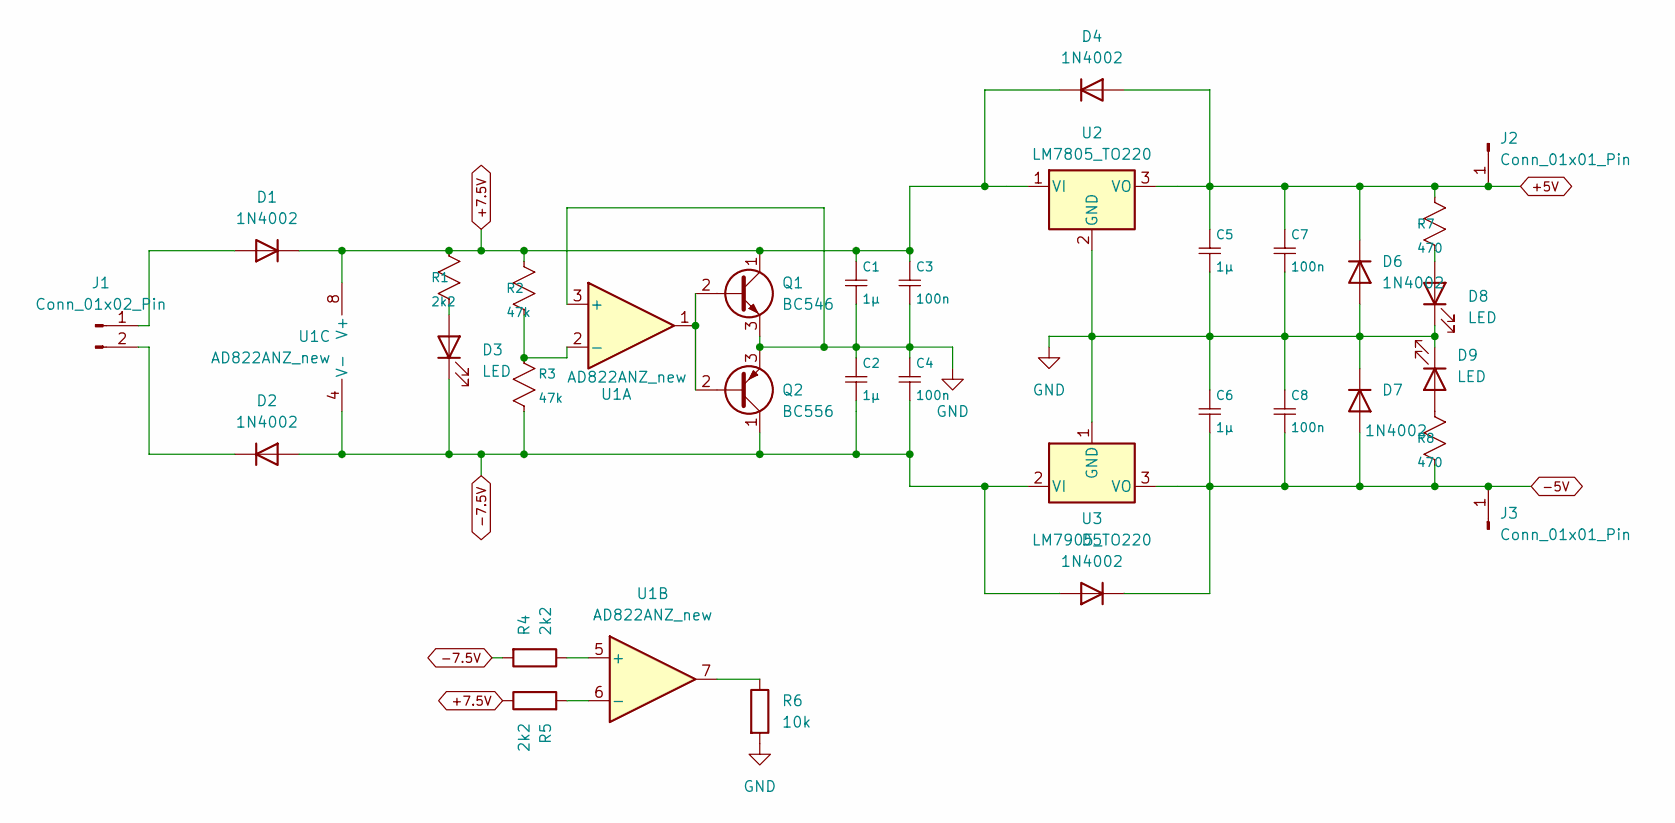
[picture p45: schematic Spannungsversorgung.kicad_sch, Frequenzgenerator Heckl & Palatz]

Parts:
C1, C2, C5, C6: 1µ; C_1206_3216Metric
C3, C4, C7, C8: 100n; C_1206_3216Metric
D1, D2, D4, D5, D6, D7: 1N4002; D_DO-41_SOD81_P10.16mm_Horizontal
D3, D8, D9: LED; LED_D3.0mm
J1: Conn_01x02_Pin; PinHeader_1x02_P2.54mm_Vertical
J2, J3: Conn_01x01_Pin; PinSocket_1x01_P2.54mm_Vertical
Q1: BC546; TO-92_Inline
Q2: BC556; TO-92_Inline
R1, R4, R5: 2k2; R_1206_3216Metric
R2, R3: 47k; R_1206_3216Metric
R6: 10k; R_1206_3216Metric
R7, R8: 470; R_1206_3216Metric
U1: AD822ANZ_new; DIP8
U2: LM7805_TO220; TO-220-3_Vertical
U3: LM7905_TO220; TO-220-3_Vertical

Connections:
+5V: C5.1, C7.1, D4.2 (A), D6.1 (K), J2.1 (Pin_1_1), R7.1, U2.3 (VO); also elsewhere on the board
+7.5V: C1.1, C3.1, D1.1 (K), D4.1 (K), Q1.1 (C), R1.1, R2.1, R5.1, U1.8 (V+), U2.1 (VI)
-5V: C6.2, C8.2, D5.1 (K), D7.2 (A), J3.1 (Pin_1_1), R8.2, U3.3 (VO); also elsewhere on the board
-7.5V: C2.2, C4.2, D2.2 (A), D3.1 (K), D5.2 (A), Q2.1 (C), R3.2, R4.2, U1.4 (V-), U3.2 (VI)
GND: C1.2, C2.1, C3.2, C4.1, C5.2, C6.1, C7.2, C8.1, D6.2 (A), D7.1 (K), D8.1 (K), D9.1 (K), Q1.3 (E), Q2.3 (E), R6.2, U1.3 (+), U2.2 (GND), U3.1 (GND); also elsewhere on the board
unnamed: D1.2 (A), J1.1
unnamed: D2.1 (K), J1.2
unnamed: D3.2 (A), R1.2
unnamed: D8.2 (A), R7.2
unnamed: D9.2 (A), R8.1
unnamed: Q1.2 (B), Q2.2 (B), U1.1
unnamed: R6.1, U1.7
unnamed: R2.2, R3.1, U1.2 (-)
unnamed: R4.1, U1.5 (+)
unnamed: R5.2, U1.6 (-)

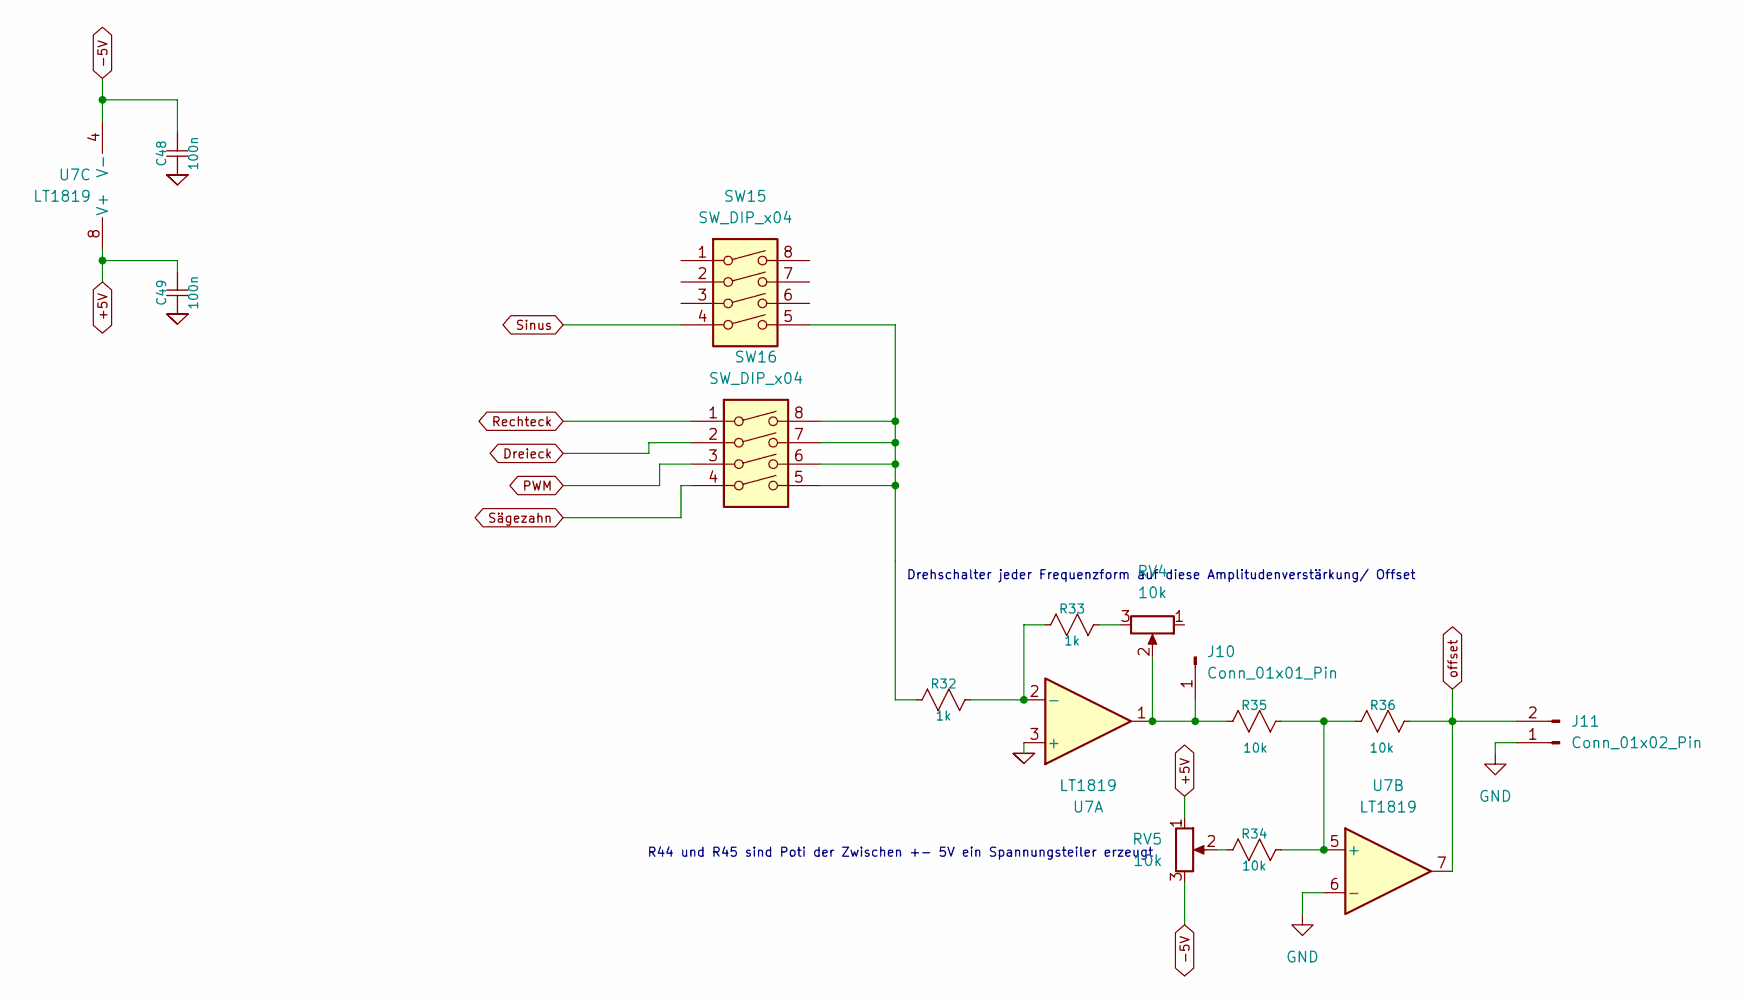
[picture p46: schematic Amplitudeneinstellung_Offset.kicad_sch, Frequenzgenerator Heckl & Palatz]

Parts:
C48, C49: 100n; C_1206_3216Metric
J10: Conn_01x01_Pin; PinSocket_1x01_P2.54mm_Vertical
J11: Conn_01x02_Pin; PinHeader_1x02_P2.54mm_Vertical
R32, R33: 1k; R_1206_3216Metric
R34, R35, R36: 10k; R_1206_3216Metric
RV4, RV5: 10k; Potentiometer_Bourns_3266Y_Vertical
SW15, SW16: SW_DIP_x04; SW_DIP_SPSTx04_Slide_6.7x11.72mm_W7.62mm_P2.54mm_LowProfile
U7: LT1819; SO-8_3.9x4.9mm_P1.27mm

Connections:
+5V: C49.1, RV5.1, U7.8 (V+); also elsewhere on the board
-5V: C48.1, RV5.3, U7.4 (V-); also elsewhere on the board
Dreieck: SW16.2; also elsewhere on the board
GND: C48.2, C49.2, J11.1, U7.3 (+), U7.6 (-); also elsewhere on the board
unnamed: J10.1 (Pin_1_1), R35.2, RV4.2, U7.1
unnamed: R32.2, SW15.5, SW16.5, SW16.6, SW16.7, SW16.8
unnamed: R33.1, RV4.3
unnamed: R34.1, RV5.2
unnamed: R32.1, R33.2, U7.2 (-)
unnamed: R34.2, R35.1, R36.2, U7.5 (+)
PWM: SW16.3; also elsewhere on the board
Rechteck: SW16.1; also elsewhere on the board
Sinus: SW15.4; also elsewhere on the board
Sägezahn: SW16.4; also elsewhere on the board
offset: J11.2, R36.1, U7.7

Notes on the sheet:
Drehschalter jeder Frequenzform auf diese Amplitudenverstärkung/ Offset
R44 und R45 sind Poti der Zwischen +- 5V ein Spannungsteiler erzeugt

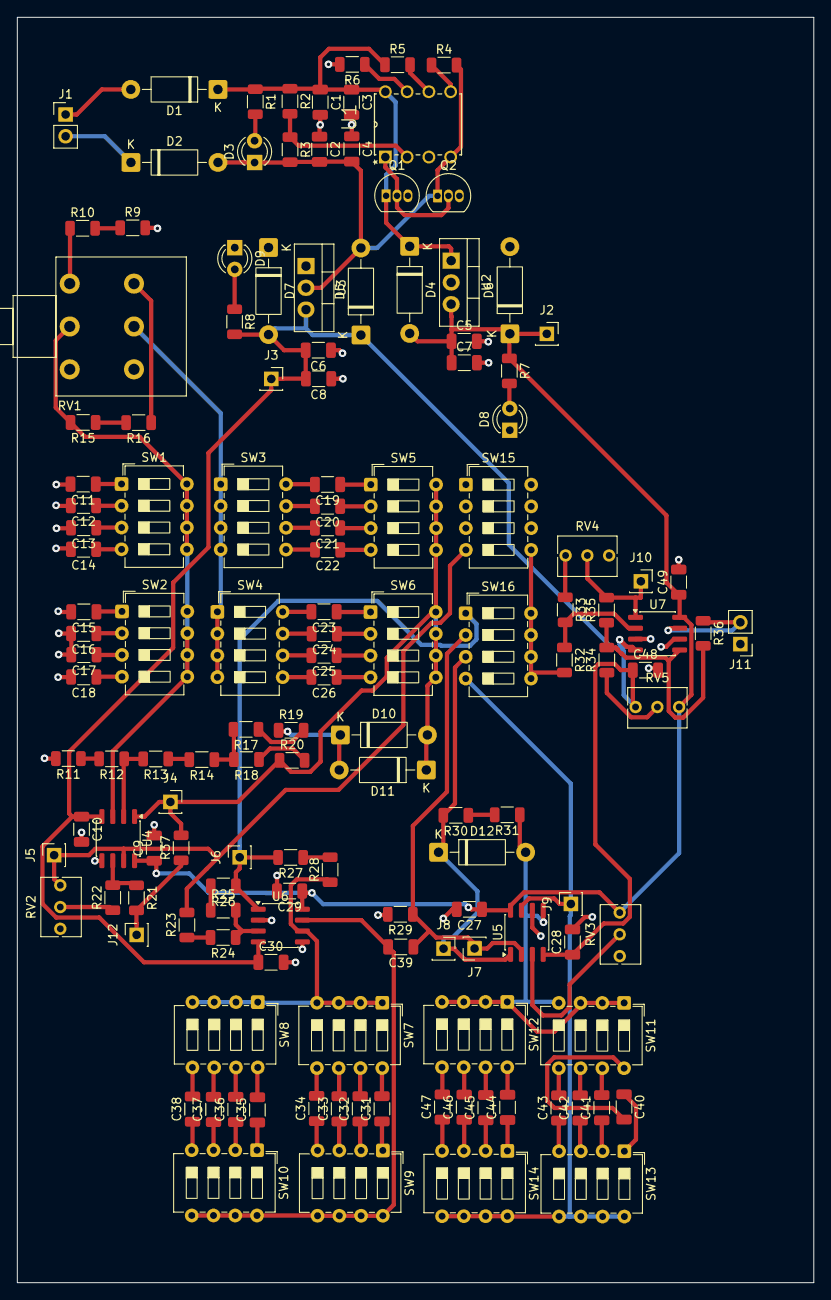
[picture p47: board PEP_Schaltplan_Layout_V1.0.kicad_pcb from above]

Board: 2 copper layers, 92.9 x 147.6 mm, 140 parts (0 on the bottom side), 109 nets.
