ReMured/PEP/(commit log)

2026-05-21 Überarbeitung und Bereinigung
    [Amplitudeneinstellung_Offset.kicad_sch, PEP_Schaltplan_Layout_V1.0.kicad_pcb, PEP_Schaltplan_Layout_V1.0.kicad_sch, Signalverarebeitung.kicad_sch, Spannungsversorgung.kicad_sch, Wien-Robinson-Generator.kicad_sch, freerouting.dsn]
2026-05-22 Pinheads eingefügt, GND überall (hoffentlich angebunden)
    [Amplitudeneinstellung_Offset.kicad_sch, PEP_Schaltplan_Layout_V1.0.kicad_pcb, Signalverarebeitung.kicad_sch, Spannungsversorgung.kicad_sch, Wien-Robinson-Generator.kicad_sch]
2026-05-22 Widerstand eingefügt um Notfall Sinus extern, einzuspeisen
    [PEP_Schaltplan_Layout_V1.0.kicad_pcb, Signalverarebeitung.kicad_sch]
2026-05-22 Hab den Pin zum einspeisen vergessen
    [PEP_Schaltplan_Layout_V1.0.kicad_pcb, Signalverarebeitung.kicad_sch]
2026-05-22 Sortierung Signalverarbeitung +Offset & Amplitude
    [PEP_Schaltplan_Layout_V1.0.kicad_pcb, PEP_Schaltplan_Layout_V1.0.kicad_sch]
2026-05-22 ic Kondensator
    [PEP_Schaltplan_Layout_V1.0.kicad_pcb]
2026-05-24 Leiterplatten größe definiert und erstes Auto Routing
    [Amplitudeneinstellung_Offset.kicad_sch, PEP_Schaltplan_Layout_V1.0.kicad_pcb, PEP_Schaltplan_Layout_V1.0.kicad_sch, Signalverarebeitung.kicad_sch, Wien-Robinson-Generator.kicad_sch, freerouting.dsn]
2026-05-24 DRC Fehler Behoben
    [PEP_Schaltplan_Layout_V1.0.kicad_pcb]
2026-05-26 Geberdaten erstellt
    [PEP_Schaltplan_Layout_V1.0-B_Cu.gbr, PEP_Schaltplan_Layout_V1.0-B_Mask.gbr, PEP_Schaltplan_Layout_V1.0-B_Paste.gbr, PEP_Schaltplan_Layout_V1.0-Edge_Cuts.gbr, PEP_Schaltplan_Layout_V1.0-F_Cu.gbr, PEP_Schaltplan_Layout_V1.0-F_Mask.gbr, PEP_Schaltplan_Layout_V1.0-F_Paste.gbr, PEP_Schaltplan_Layout_V1.0-NPTH.drl]
2026-05-26 Gerberdaten in .zip
2026-06-20 Upps vergessen
    [Wien-Robinson-Generator.kicad_sch]
